Loic74650/PoolMaster/docs/Blynk.jpg

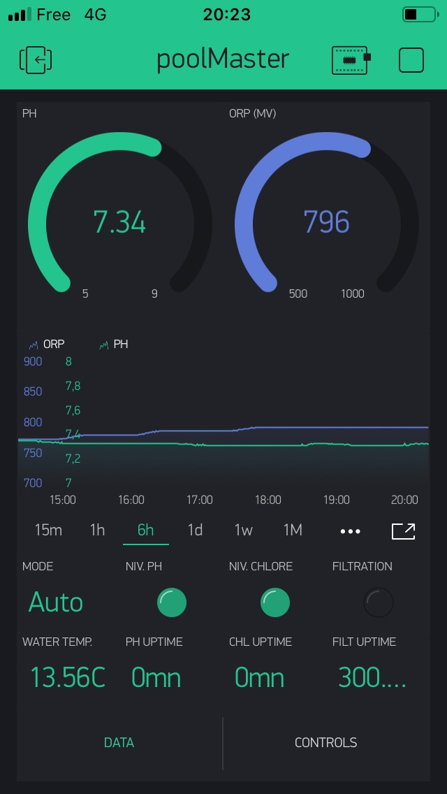
docs/Blynk.jpg
