Loic74650/PoolMaster/docs/Grafana2.png

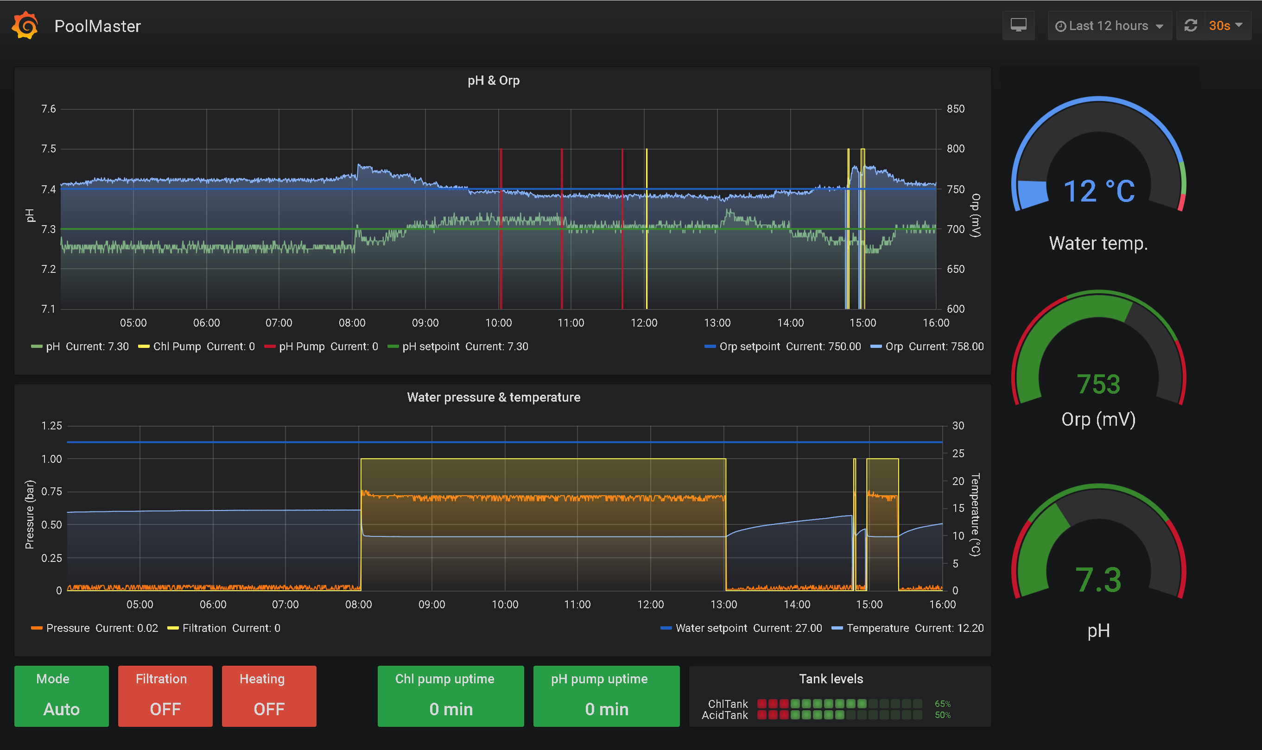
docs/Grafana2.png
