Loic74650/PoolMaster/docs/MeasuringChamberPickup.JPG

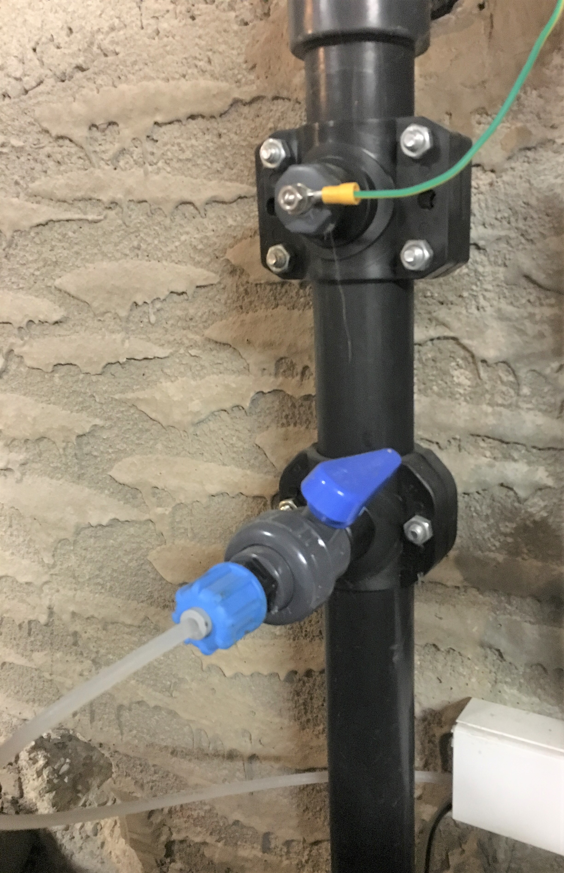
docs/MeasuringChamberPickup.JPG
