Loic74650/PoolMaster/docs/OneWayInjectionNozzles.JPG

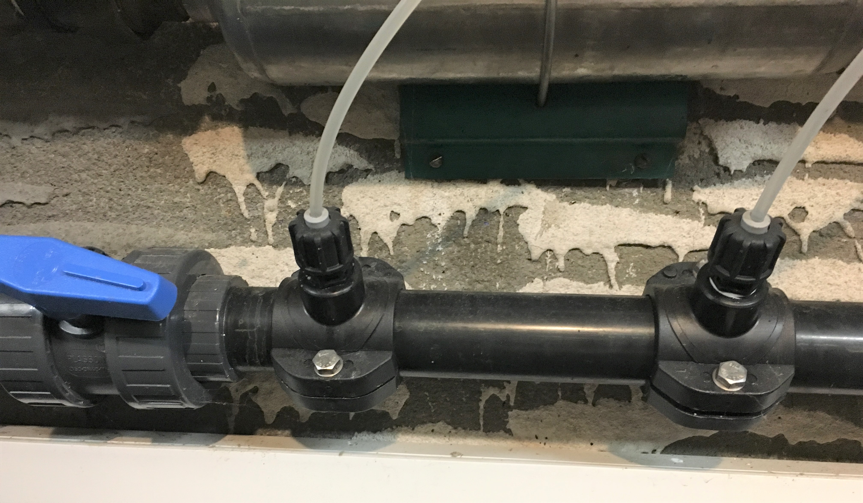
docs/OneWayInjectionNozzles.JPG
