Loic74650/PoolMaster/docs/Plumbing.png

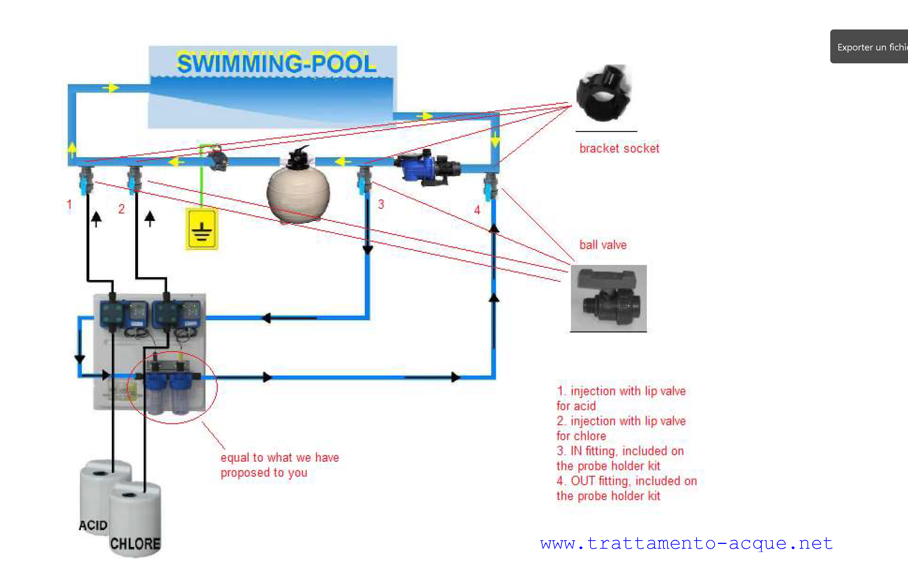
docs/Plumbing.png
