Loic74650/PoolMaster/docs/PoolMaster.jpg

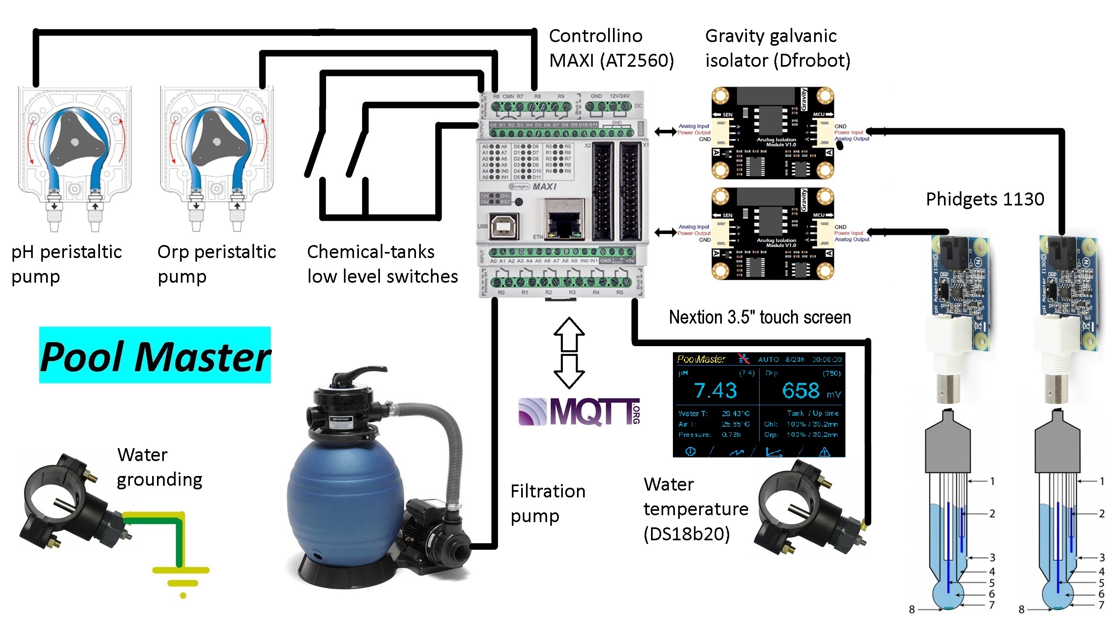
docs/PoolMaster.jpg
