Loic74650/PoolMaster/docs/PoolMaster_2.jpg

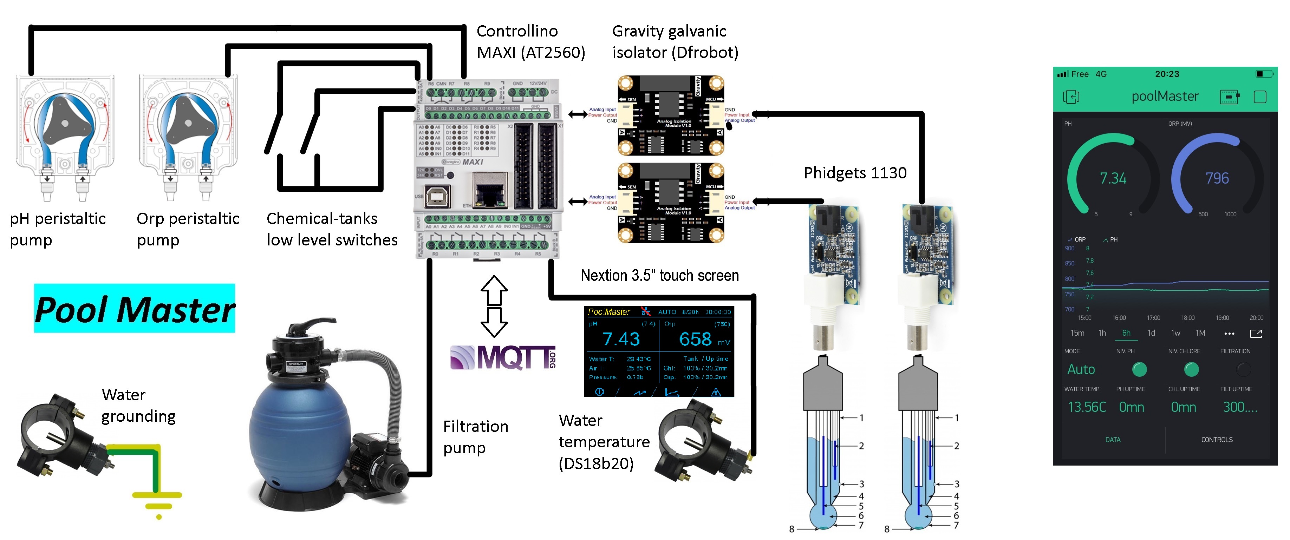
docs/PoolMaster_2.jpg
