Loic74650/PoolMaster/docs/TemperatureProbe.JPG

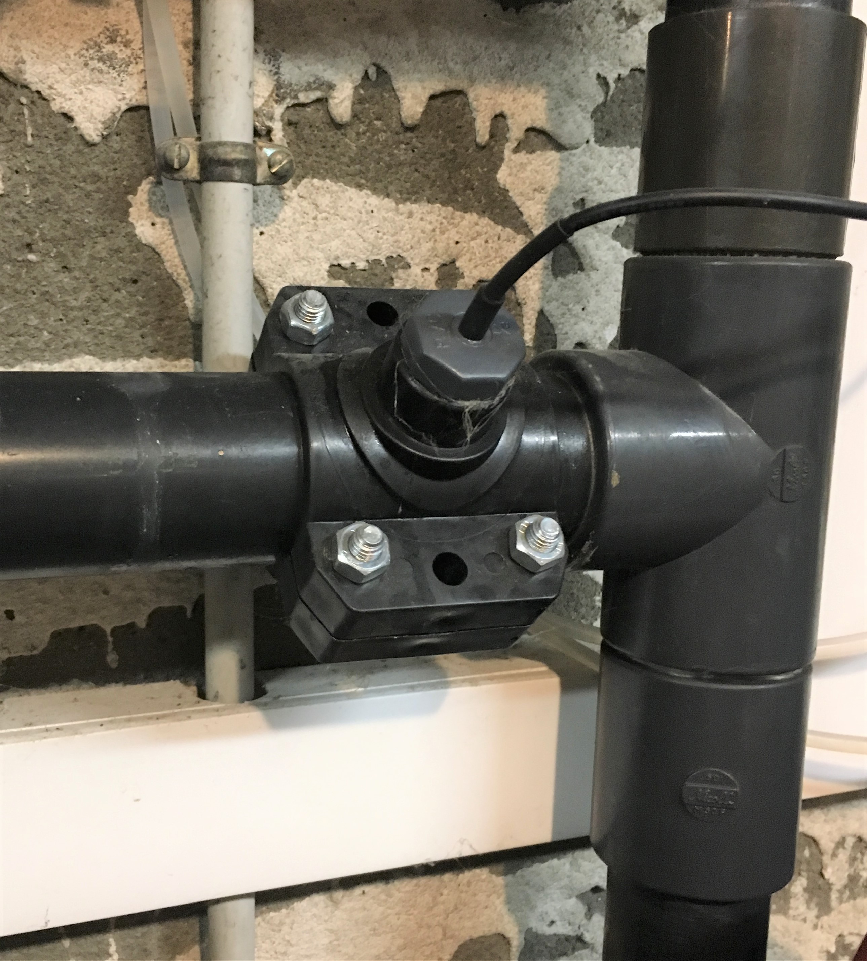
docs/TemperatureProbe.JPG
