Loic74650/PoolMaster/docs/Probes cross-talk test.jpg

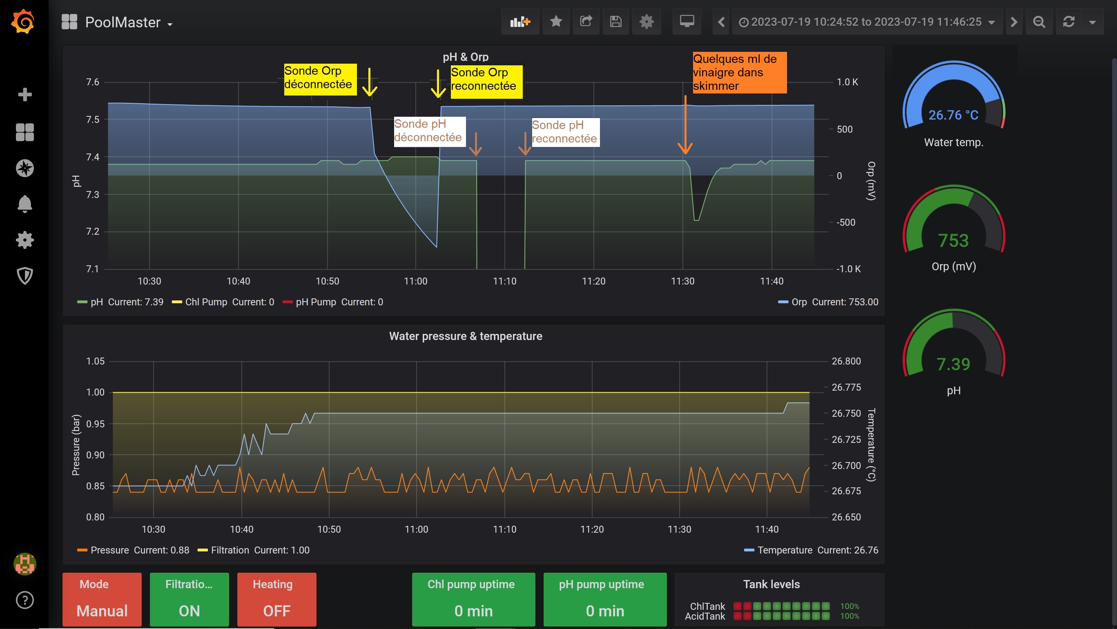
docs/Probes cross-talk test.jpg
