Loic74650/PoolMaster/(threads)

Thread 1 (2020-01-17):

Ajout Wifi NodeMCU V3 Esp8266

Cheveux, 2020-01-17:
très bon projet que je souhaite mettre en place chez moi mais étant tout nouveau dans ce domaine, j'essaye depuis quelques jours de remplacer la Shield ethernet par une nodeMcu V3 a base d'ESP8266 (ESP-12E).
Si tu as une idée sur comment flasher l'ESP pour pouvoir l'utiliser comme un Shield.

Loic74650, 2020-01-17:
Hello Cheveux

Désolé je n’ai pas d’expérience avec ESP

Loic

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

Cheveux, 2020-01-18:
ok merci pour l'info penses tu que si je prend un Arduino wifi R3 atmega2560 (a base de esp8266) je pourrais facilement adapter le projet ? j'ai besoin de passer par wifi car je ne souhaite pas passer par CPL dans mon local

Loic74650, 2020-01-18:
A partir du moment où tu restes sur des micro compatibles avec l’IDE Arduino, ça devrait aller. Par contre commence par passer en revue les librairies du projet PoolMaster et vérifie qu’elles prennent en charge le micro vers lequel tu veux migrer

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

Closed 2020-02-05.

Thread 5 (2020-05-25):

{"PSIHigh":1.0}  upper or lower limit?

bbwouters, 2020-05-25:
{"PSIHigh":1.0}                  -> set the water high-pressure threshold (1.0bar in this example). When water pressure is over that threshold, an error flag is set.

Could it be the PSIHigh sets the lower limit for the filtration pump to run in stead of the upper limit?

 //If filtration pump has been running for over 7secs but pressure is still low, stop the filtration pump, something is wrong, set error flag
    if(FiltrationPump.IsRunning() && ((millis() - FiltrationPump.LastStartTime)>7000) && (storage.PSIValue < storage.PSI_MedThreshold))
    {
      FiltrationPump.Stop();

Setting it at 1 bar in my cofig happily runs the pump generating a constant  5 bar.

I think the check is correct "if you see no pressure buildup there is a problem and stop the pomp" but the description is incorrect.

Loic74650, 2020-05-25:
I think all is correct, BUT:

*	storage.PSI_MedThreshold Is the variable used to detect a low pressure (0.25b by default in EEPROM, and no API function to change it)
*	storage.PSI_HighThreshold Is the variable to detect a high pressure (sand filter needs cleaning) but the error detection / flag is not implemented

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

bbwouters, 2020-05-25:
OK that explains why I do not get an error at 5 bar with 1.0 bar threshold.

Sorry for creating confusion.

Van: "Loic74650" <notifications@github.com>
Aan: "Loic74650/PoolMaster" <PoolMaster@noreply.github.com>
Cc: "bwouters" <bwouters@telenet.be>, "Author" <author@noreply.github.com>
Verzonden: Maandag 25 mei 2020 23:39:47
Onderwerp: Re: [Loic74650/PoolMaster] {"PSIHigh":1.0} upper or lower limit? (#5)

I think all is correct, BUT:

* storage.PSI_MedThreshold Is the variable used to detect a low pressure (0.25b by default in EEPROM, and no API function to change it)
* storage.PSI_HighThreshold Is the variable to detect a high pressure (sand filter needs cleaning) but the error detection / flag is not implemented

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

Closed 2020-05-27.

Thread 19 (2020-05-31):

{"DelayPID":60}  when re-start during filter pump window

bbwouters, 2020-05-31:
Are we sure if the system is re-booted during the Flirtation pump window/ hours the PID regulation is delayed and does not start immediately regulating based on water left in the tubes (and therefore not reflecting real water quality?  Same question is valid when pump is manually stopped and started  during filtration hours. (As a matter of safety).

So does PHRegulationCallback(Task* me) checks when Firltration pump was last started? I don't think so but your insight would be appreciated.

Loic74650, 2020-05-31:
Correct it does not.

I'd like the PHRegulationCallback(Task* me) to remain as clean and simple as possible, so I suggest that any future checks should be either performed in the generic loop or in the lower level Pump class.

In this particular case the simplest way to do this I think, is to reset the FiltrationPump.UpTime property after a manual stop/restart of the filtration. That way it will wait for another DelayPID before it regulates again. The downside is that it will messup the filtration real duration statistic for that particular day (maybe not so critical).

A slightly more correct/complex way of doing things would be to increase the value of storage.DelayPIDs variable by the FiltrationPump.UpTime value after each start/stop of the filtration:

storage.DelayPIDs += FiltrationPump.UpTime

That way when it restarts, it has to wait for another while before starting the regulation again.
At midnight, storage.DelayPIDs should be reset to its default value.

We also have to discuss whether EmergencyStopFiltPump should be reset at midnight or not (ie. should the double-tap feature be used for long-term filtration management or just small daily tasks)

bbwouters, 2020-05-31:
In my opinion: EmergencyStopFiltPump should be reset at midnight , "emergency" should the double-tap feature be used for small daily tasks, but a warning in the documentation it will restart next day.

Van: "Loic74650" <notifications@github.com>
Aan: "Loic74650/PoolMaster" <PoolMaster@noreply.github.com>
Cc: "bwouters" <bwouters@telenet.be>, "Author" <author@noreply.github.com>
Verzonden: Zondag 31 mei 2020 15:13:15
Onderwerp: Re: [Loic74650/PoolMaster] {"DelayPID":60} when re-start during filter pump window (#19)

Correct it does not.

I'd like the PHRegulationCallback(Task* me) to remain as clean and simple as possible, so I suggest that any future checks should be either performed in the generic loop or in the lower level Pump class.

In this particular case the simplest way to do this I think, is to reset the FiltrationPump.UpTime property after a manual stop/restart of the filtration. That way it will wait for another DelayPID before it regulates again. The downside is that it will messup the filtration real duration statistic for that particular day (maybe not so critical).

A slightly more correct/complex way of doing things would be to increase the value of storage.DelayPIDs variable by the FiltrationPump.UpTime value after each start/stop of the filtration:

storage.DelayPIDs += FiltrationPump.UpTime

That way when it restarts, it has to wait for another while before starting the regulation again.
At midnight, storage.DelayPIDs should be reset to its default value.

We also have to discuss whether EmergencyStopFiltPump should be reset at midnight or not (ie. should the double-tap feature be used for long-term filtration management or just small daily tasks)

—
You are receiving this because you authored the thread.
Reply to this email directly, [ https://github.com/Loic74650/PoolMaster/issues/19#issuecomment-636469779 | view it on GitHub ] , or [ https://github.com/notifications/unsubscribe-auth/AO7R6ZSMCNQJKHAPQR32LZ3RUJJWXANCNFSM4NPEVYHA | unsubscribe ] .

Loic74650, 2020-05-31:
`In my opinion: EmergencyStopFiltPump should be reset at midnight , "emergency" should the double-tap feature be used for small daily tasks, but a warning in the documentation it will restart next day.`

I agree and will make the change

bbwouters, 2020-05-31:
unsigned long LastStartTime;

can also be used to make a check with to take into account PID delay

I'll have a look

Van: "Loic74650" <notifications@github.com>
Aan: "Loic74650" <PoolMaster@noreply.github.com>
Cc: "bwouters" <bwouters@telenet.be>, "Author" <author@noreply.github.com>
Verzonden: Zondag 31 mei 2020 15:13:15
Onderwerp: Re: [Loic74650/PoolMaster] {"DelayPID":60} when re-start during filter pump window (#19)

Correct it does not.

I'd like the PHRegulationCallback(Task* me) to remain as clean and simple as possible, so I suggest that any future checks should be either performed in the generic loop or in the lower level Pump class.

In this particular case the simplest way to do this I think, is to reset the FiltrationPump.UpTime property after a manual stop/restart of the filtration. That way it will wait for another DelayPID before it regulates again. The downside is that it will messup the filtration real duration statistic for that particular day (maybe not so critical).

A slightly more correct/complex way of doing things would be to increase the value of storage.DelayPIDs variable by the FiltrationPump.UpTime value after each start/stop of the filtration:

storage.DelayPIDs += FiltrationPump.UpTime

That way when it restarts, it has to wait for another while before starting the regulation again.
At midnight, storage.DelayPIDs should be reset to its default value.

We also have to discuss whether EmergencyStopFiltPump should be reset at midnight or not (ie. should the double-tap feature be used for long-term filtration management or just small daily tasks)

—
You are receiving this because you authored the thread.
Reply to this email directly, [ https://github.com/Loic74650/PoolMaster/issues/19#issuecomment-636469779 | view it on GitHub ] , or [ https://github.com/notifications/unsubscribe-auth/AO7R6ZSMCNQJKHAPQR32LZ3RUJJWXANCNFSM4NPEVYHA | unsubscribe ] .

Loic74650, 2020-06-01:
`unsigned long LastStartTime; can also be used to make a check with to take into account PID delay`

Correct. LastStartTime could be used to check how long the filtration was stopped for. If longer than, say, 1 hour, a delay should be applied before restarting the PIDs

Loic74650, 2020-06-02:
I gave some thoughts to this issue and how to handle it.
It becomes unecessarily complicated once you wish to handle several double-taps in a row.

Therefore v5.0.0 is now using a simple check before it starts the PIDS, I have replaced the following condition:

(FiltrationPump.UpTime/1000/60 > storage.DelayPIDs)

with:

(FiltrationPump.LastStartTime / 1000 / 60 > storage.DelayPIDs)

It has the inconvenience to enforce a DelayPID every time you stop/restart the filtration but in practice that should not be abig issue and that keeps things simple

bbwouters, 2020-06-02:
Perfect solution!

Van: "Loic74650" <notifications@github.com>
Aan: "Loic74650" <PoolMaster@noreply.github.com>
Cc: "bwouters" <bwouters@telenet.be>, "Author" <author@noreply.github.com>
Verzonden: Dinsdag 2 juni 2020 12:49:27
Onderwerp: Re: [Loic74650/PoolMaster] {"DelayPID":60} when re-start during filter pump window (#19)

I gave some thoughts to this issue and how to handle it.
It becomes unecessarily complicated once you wish to handle several double-taps in a row.

Therefore v5.0.0 is now using a simple check before it starts the PIDS, I have replaced the following condition:

(FiltrationPump.UpTime/1000/60 > storage.DelayPIDs)

with:

(FiltrationPump.LastStartTime / 1000 / 60 > storage.DelayPIDs)

It has the inconvenience to enforce a DelayPID every time you stop/restart the filtration but in practice that should not be abig issue and that keeps things simple

—
You are receiving this because you authored the thread.
Reply to this email directly, [ https://github.com/Loic74650/PoolMaster/issues/19#issuecomment-637456122 | view it on GitHub ] , or [ https://github.com/notifications/unsubscribe-auth/AO7R6ZRF5VA7ILOVXNSUVYDRUTKLPANCNFSM4NPEVYHA | unsubscribe ] .

Loic74650, 2020-06-16:
Hi Boris

Found the bug with DelayPID behaviour and the use of LastStartTime

I fixed it

Cheers

Loic

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

bbwouters, 2020-06-16:
Perfect!

Van: "Loic74650" <notifications@github.com>
Aan: "Loic74650" <PoolMaster@noreply.github.com>
Cc: "bwouters" <bwouters@telenet.be>, "Author" <author@noreply.github.com>
Verzonden: Dinsdag 16 juni 2020 11:17:48
Onderwerp: Re: [Loic74650/PoolMaster] {"DelayPID":60} when re-start during filter pump window (#19)

Hi Boris

Found the bug with DelayPID behaviour and the use of LastStartTime

I fixed it

Cheers

Loic

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

Closed 2020-06-02.

Thread 24 (2020-06-18):

Wrong dimension s/h

bbwouters, 2020-06-18:
{"pHPumpFR":1.5}                 -> call this command to set pH pump flow rate un L/s. In this example 1.5L/s
  {"ChlPumpFR":3}                  -> call this command to set Chl pump flow rate un L/s. In this example 3L/s

needs to be L/h no?

Loic74650, 2020-06-18:
Ah yes, thx, corrected it

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

Closed 2020-06-18.

Thread 25 (2020-06-18):

Relay comments to be adjusted

bbwouters, 2020-06-18:
R1: state of Relay1
    R2: state of Relay1
    R6: state of Relay1
    R7: state of Relay1

   R1: state of Relay1
    R2: state of Relay2
    R6: state of Relay6
    R7: state of Relay7

Loic74650, 2020-06-18:
Corrected, thank you

Closed 2020-06-18.

Thread 26 (2020-06-27):

arduino-queue does not free memory

Faexa, 2020-06-27:
Hi,
I'm building my own script step by step, learning arduino by the way and C programming, using (all) parts of yours.
I noticed that the arduino queue you're using (https://github.com/sdesalas/Arduino-Queue.h) does not free memory when queue is emptying.
If I spam the queue to the max with MQTT commands, it will eat memory up to (max number of items queued) * (MQTTClient packet size, which is 128bits by default) (so with your settings 1k), and will never release these allocation when emptying.
I tried this arduino-queue (https://github.com/EinarArnason/ArduinoQueue) which behave differently and release the allocations. I get the same free RAM when the queue is empty that I had before spaming the queue.

It's a corner case, I doubt we would spam ourselves with MQTT commands...

Thanks for you good job with this script ! Really like it :)

Loic74650, 2020-06-27:
Thank you Faexa,

This is not really a bug but rather a poor RAM management from the current queue library in conjunction with my code using the String class which also does a poor job at managing RAM...  The String objects holding the command payloads are allocated and never released by the queue class, as you noted. Then the String objects can only grow in size with longer commands coming in, and never decrease in size even with smaller commands coming in, leading to what you saw.

So in the development branch of the project (version 5.0.0 coming up) I have replaced the current queue library with the one you found, which does a much better job, thank you!

Closed 2020-07-01.

Thread 27 (2020-12-30):

Nextion variable update missing

Gixy31, 2020-12-30:
When updating Filtration Start/Stop hours, the page0.vaStaSto.txt should be set with the new string in order to force updating of the field on all pages.
add this line after line #154:
myNex.writeStr(F("page0.vaStaSto.txt"), temp);

Loic74650, 2020-12-30:
Thanks Gixy31, I believe I fixed that issue in my December 1st update of the develop branch, kindly confirm

Gixy31, 2020-12-30:
You're right! I was using the master branch.
Another fix in your pump library: on many relay boards, the relays are activated when pulling the input LOW ; to cope with that, you must not only invert the PUMP_ON, PUMP_OFF, INTERLOCK_OK and INTERLOCK_NOK constants, but you must also change the _isrunning_  and _Interlock_ functions like this:
return (digitalRead(isrunningsensorpin) == PUMP_ON);
return (digitalRead(interlockpin) == PUMP_ON);
And for the addtionnal relays commands, the digitalWrite instructions should also be inverted in the ProcessCommand() function.
All the best,
Denis

Loic74650, 2021-01-01:
Pump library: yes, nice catch
I think however that:

return (digitalRead(interlockpin) == PUMP_ON);

should be:

return (digitalRead(interlockpin) == INTERLOCK_OK);

Gixy31, 2021-01-01:
Exact, copiė collé malheureuxLe 1 janv. 2021 20:36, Loic74650 <notifications@github.com> a écrit :
Pump library: yes, nice catch
I think however that:
return (digitalRead(interlockpin) == PUMP_ON);
should be:
return (digitalRead(interlockpin) == INTERLOCK_OK);

—You are receiving this because you authored the thread.Reply to this email directly, view it on GitHub, or unsubscribe.

Closed 2021-01-01.

Thread 28 (2021-03-18):

Compiling error

jdienlin, 2021-03-18:
Hi!
Really fascinated by your project! I have installed all libraries, using a Controllino Maxi board, however I receive the following error while compiling:

"Archiving built core (caching) in: C:\Users\jdienlin\AppData\Local\Temp\arduino_cache_542260\core\core_CONTROLLINO_Boards_avr_controllino_maxi_0c812875ac70eb4a9b385d8fb077f54c.a
C:\Users\jdienlin\Documents\Arduino\PoolMaster-master\PoolMaster-master\source\PoolMaster\PoolMaster.ino: In function 'simpLinReg':

PoolMaster:1876: error: unable to find a register to spill in class 'POINTER_REGS'

 }

 ^

PoolMaster:1876: error: this is the insn:

(insn 52 51 54 3 (set (reg:SF 67 [ D.2628 ])

        (mem:SF (post_inc:HI (reg:HI 82 [ ivtmp.77 ])) [12 MEM[base: _52, offset: 0B]+0 S4 A8])) C:\Users\jdienlin\Documents\Arduino\PoolMaster-master\PoolMaster-master\source\PoolMaster\PoolMaster.ino:1863 100 {*movsf}

     (expr_list:REG_INC (reg:HI 82 [ ivtmp.77 ])

        (nil)))

"

Any ideas?

Thanks!
Jonathan

Loic74650, 2021-03-18:
Hi
It's a bug from the compiler, you have to update the IDE and the arduino.avr-gcc

jdienlin, 2021-03-18:
Hi, thanks for the quick reply. Updating the compiler fixed the issue - big THANK YOU!

Closed 2021-03-18.

Thread 29 (2021-06-21):

information

maury77, 2021-06-21:
I would need a simplified version for water monitoring.

It is possible to use it on

Arduino UNO R3 ATmega328P + WiFi ESP8266

arnolde, 2021-06-21:
I would think even an ESP8266 alone should do the trick... I'd be interested too, in case anybody gets into that.
I recently bought a PH-803W pool controller for 80€ on Aliexpress, it containes an ESP8266 too, but also a square microcontroller (type filed off). It's not bad, the app sucks, but I wrote a perl script to catch the UDP broadcasts of the ph+orp values and post them to an influxdb+grafana instance on my webserver. Other stuff includes Maxim ICL 7612D (for pH) and 7612A (for ORP) opamps and 2xTEL 6N137 optocouplers.

Loic74650, 2021-06-21:
PoolMAster was ported to ESP32 by @Gixy31, see here: https://github.com/Gixy31/ESP32-PoolMaster

Closed 2021-07-11.

Thread 35 (2023-07-02):

Pump action is inverted

henjo, 2023-07-02:
Hi,
Thanks for a great project.
I am trying to build a chlorine controller with a Controllino Maxi with the Poolmaster SW.
At start the ORP and chlorine pump relays are all turned on and I have tracked down the problem to the definition of PUMP_ON macro in Pump.h. It is defined as active low which seems to be opposite to the way my Controllino hardware works. If the relay action is hardware dependent maybe it is good to have it as a parameter to the Pump class.

Loic74650, 2023-07-03:
Hi
Good point, will add it to the todo list!

Loic74650, 2023-07-04:
On a second thought, this issue could also come up with the other defines such as TANK_FULL/TANK_EMPTY and INTERLOCK_OK/INTERLOCK_NOK, but it would not be super elegant to have them all as parameters in the class constructor, would it? Any suggestion for a better way to do this?

henjo, 2023-07-05:
How about adding only one of the constants (PUMP_ON, TANK_FULL,
INTERLOCK_OK) as parameters to the constructor since they are binary
constants. So then there are 3 additional parameters to the constructor.
Not super elegant either.

/Henrik

2023-07-04 22:40 skrev Loic74650:

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

Links:
------
[1]
https://github.com/Loic74650/PoolMaster/issues/35#issuecomment-1620724351
[2]
https://github.com/notifications/unsubscribe-auth/AAAIXZ5ZDRXLDZM7WO55LXLXOR5UXANCNFSM6AAAAAAZ3OI3Z4

Thread 44 (2025-05-16):

PH Temperature compensation

masterpj555, 2025-05-16:
Hi there Loic! Sorry for messaging you here as my knowledge of github is low.

Amazing project! I started attemtping to build my own using poolmaster.

I found some really good industrial PH sensors far cheaper then atlas scientific with temperature compensation
(140 with a controller, 89 without a controller compared to 319 from atlas scientific).

Now my question: Is it possible to add PH temperature compensation to poolmaster? It would increase accuracy.
I was under the impression the PH/ORP sensor board only does amplification and DAC.

Loic74650, 2025-05-16:
+/-0.1 is probably maintained within that range without temp compensation. Whats more, reference solutions used to calibrate pH indicate the pH value to be used over that temperature range, so in a way it is already compensated for without actively doing it in the code, assuming the temperature stays relatively constant between calibrations. In the last resort, the function GetMeas() in the code shows how to use temp. compensation if really desired (it may need to be updated to work with the pH_Orp board)

masterpj555, 2025-05-16:
0.1 is plenty sufficient! I'm mostly wondering because i've seen some really eratic charts of scientific publications.. i have to check how far the drift is.. but in my country it (and so in france i believe) it can get quite cold and hot sporadically in the summer.

For example 15 degrees to sudden 28 degrees another day . I want to add wood fired and solar heated pool heating to my pool which means temps do tend to spike every now and then and not be consistent. if it despite that stays within 0.1 degrees then no problem but somehow I doubt it will.

masterpj555, 2025-05-16:
> pool

it may be wise to have redundancy anyway! in case of the sending a low cost temperature sensor can be added as a sort of low effort comparitor just for the pure sake of failure of a temperature sensor.. it wont be perfect but that redundancy can be used for error reporting. I do understand 2 probes is costly since it's a consumable.

arnolde, 2025-05-16:
> For example 15 degrees to sudden 28 degrees another day

Your pool water won't change temerature that fast. I have 20m³ and the temperature only sinks 1° or max 2° overnight.
During Covid I heated it to 32° in winter and it went down 4° overnight (freezing temps outside, covered the surface in 4cm styrofoam when not using) (not recommended btw, they soaked up the water)

masterpj555, 2025-05-16:
> > For example 15 degrees to sudden 28 degrees another day
>
> Your pool water won't change temerature that fast. I have 20m³ (completely underground) and the temperature only sinks 1° or max 2° overnight. During Covid I heated it to 32° in winter and it went down 4° overnight (freezing temps outside, covered the surface in 4cm styrofoam when not using) (not recommended btw, they soaked up the water)

fair but since you want this system to sort of reduce your work on the pool the more hands off it is the better... say you could leave it more unattended over a period of 2~3 weeks youll have a fair bit of drift which will affect dosing.. possibly more chemicals are wasted in the process of adjusting back and forth.

Closed 2025-05-16.
