Loic74650/PoolMaster/source/PoolMaster.ino/PoolMaster.ino.ino

/*
Arduino/Controllino-Maxi (ATmega2560) based Ph/ORP regulator for home pool sysem. No warranty, use at your own risk
(c) Loic74 <loic74650@gmail.com> 2018

***Compatibility***
For this sketch to work on your setup you must change the following in the code:
- possibly the pinout definitions in case you are not using a CONTROLLINO MAXI board
- the code related to the RTC module in case your setup does not have one
- MAC address of DS18b20 water temperature sensor
- MAC and IP address of the Ethernet shield
- MQTT broker IP address and login credentials
- possibly the topic names on the MQTT broker to subscribe and publish to
- the Kp,Ki,Kd parameters for both PID loops in case your peristaltic pumps have a different throughput than 2Liters/hour. For instance, if twice more, divide the parameters by 2

***Brief description:***
Three main metrics are measured and periodically reported over MQTT: water temperature, PH and ORP values
Pumps states, tank-level states and other parmaters are also periodically reported
Two PID regulation loops are running in parallel: one for PH, one for ORP
PH is regulated by injecting Acid from a tank into the pool water (a relay starts/stops the Acid peristaltic pump)
ORP is regulated by injecting Chlorine from a tank into the pool water (a relay starts/stops the Chlorine peristaltic pump)
Defined time-slots and water temperature are used to start/stop the filtration pump for a daily given amount of time (a relay starts/stops the filtration pump) 
A lightweight webserver provides a simple dynamic webpage with a summary of all system parameters
Communication with the system is performed using the MQTT protocol over an Ethernet connection to the local network/MQTT broker.

Every 30 seconds (by default), the system will publish on the "PoolTopic" (see in code below) the following payloads in Json format:

Temp: measured Water temperature value in °C
Ph: measured Ph value
PhError/100: Ph PID regulation loop instantaneous error
Orp: measured Orp (Redox) value
OrpError/100: Orp PID regulation loop instantaneous error 
FiltUpTime: current running time of Filtration pump in seconds (reset every 24h)
PhUpTime: current running time of Ph pump in seconds (reset every 24h)
ChlUpTime: current running time of Chl pump in seconds (reset every 24h)
IO & IO2: two variables of type BYTE where each individual bit is the state of a digital input on the Arduino. These are:

IO:
FiltPump: current state of Filtration Pump (1=on, 0=off)
PhPump: current state of Ph Pump (1=on, 0=off)
ChlPump: current state of Chl Pump (1=on, 0=off)
PhlLevel: current state of Acid tank level (0=empty, 1=ok)
ChlLevel: current state of Chl tank level (0=empty, 1=ok)
Mode: (0=manual, 1=auto). 
pHErr: pH pump overtime error flag
ChlErr: Chl pump overtime error flag

IO2:
pHPID: current state of pH PID regulation loop (1=on, 0=off)
OrpPID: current state of Orp PID regulation loop (1=on, 0=off)
   
***MQTT API***
Below are the Payloads/commands to publish on the "PoolTopicAPI" topic (see in code below) in Json format in order to launch actions on the Arduino:
{"Mode":1} or {"Mode":0}         -> set "Mode" to manual (0) or Auto (1). In Auto, filtration starts/stops at set times of the day 
{"FiltPump":1} or {"FiltPump":0} -> manually start/stop the filtration pump. 
{"ChlPump":1} or {"ChlPump":0}   -> manually start/stop the Chl pump to add more Chlorine
{"PhPump":1} or {"PhPump":0}     -> manually start/stop the Acid pump to lower the Ph
{"PhPID":1} or {"PhPID":0}       -> start/stop the Ph PID regulation loop
{"OrpPID":1} or {"OrpPID":0}     -> start/stop the Orp PID regulation loop
{"PhCalib":[4.02,3.8,9.0,9.11]}  -> multi-point linear regression calibration (minimum 1 point-couple, 6 max.) in the form [ProbeReading_0, BufferRating_0, xx, xx, ProbeReading_n, BufferRating_n]
{"OrpCalib":[450,465,750,784]}   -> multi-point linear regression calibration (minimum 1 point-couple, 6 max.) in the form [ProbeReading_0, BufferRating_0, xx, xx, ProbeReading_n, BufferRating_n]
{"PhSetPoint":7.4}               -> set the Ph setpoint, 7.4 in this example
{"OrpSetPoint":750.0}            -> set the Orp setpoint, 750mV in this example
{"WSetPoint":27.0}               -> set the water temperature setpoint, 27.0deg in this example (for future use. Water heating not handled yet)
{"WTempLow":10.0}                -> set the water low-temperature threshold below which there is no need to regulate Orp and Ph (ie. in winter)
{"OrpPIDParams":[2857,0,0]}      -> respectively set Kp,Ki,Kd parameters of the Orp PID loop. In this example they are set to 2857, 0 and 0
{"PhPIDParams":[1330000,0,0.0]}  -> respectively set Kp,Ki,Kd parameters of the Ph PID loop. In this example they are set to 1330000, 0 and 0.0
{"OrpPIDWSize":1800000}           -> set the window size of the Orp PID loop in msec, 30mins in this example
{"PhPIDWSize":1800000}            -> set the window size of the Ph PID loop in msec, 30mins in this example
{"Date":[1,1,1,18,13,32,0]}      -> set date/time of RTC module in the following format: (Day of the month, Day of the week, Month, Year, Hour, Minute, Seconds), in this example: Monday 1st January 2018 - 13h32mn00secs
{"FiltT0":9}                     -> set the earliest hour (9:00 in this example) to run filtration pump. Filtration pump will not run beofre that hour
{"FiltT1":20}                    -> set the latest hour (20:00 in this example) to run filtration pump. Filtration pump will not run after that hour
{"PubPeriod":30}                 -> set the periodicity (in seconds) at which the system info (pumps states, tank levels states, measured values, etc) will be published to the MQTT broker
{"PumpsMaxUp":1800}              -> set the Max Uptime (in secs) for the Ph and Chl pumps over a 24h period. If over, PID regulation is stopped and a warning flag is raised
{"Clear":1}                      -> reset the pH and Orp pumps overtime error flags in order to let the regulation loops continue. "Mode", "PhPID" and "OrpPID" commands need to be switched back On (1) after an error flag was raised

***Libraries***
https://github.com/256dpi/arduino-mqtt/releases
https://github.com/CONTROLLINO-PLC/CONTROLLINO_Library
https://github.com/PaulStoffregen/OneWire
https://github.com/milesburton/Arduino-Temperature-Control-Library
https://github.com/RobTillaart/Arduino/tree/master/libraries/RunningMedian
https://github.com/prampec/arduino-softtimer
https://github.com/bricofoy/yasm
https://github.com/br3ttb/Arduino-PID-Library
https://github.com/bblanchon/ArduinoJson
https://github.com/arduino-libraries/LiquidCrystal

*/ 
#include <SPI.h>
#include <Ethernet.h>
#include <MQTT.h>
#include <SD.h>
#include "OneWire.h"
#include <DallasTemperature.h>
#include <Controllino.h>
#include <EEPROM.h>
#include <RunningMedian.h>
#include <SoftTimer.h>
#include <yasm.h>
#include <PID_v1.h>
#include <Streaming.h>
#include <LiquidCrystal.h>
#include <avr/wdt.h>
#include <stdlib.h>
#include <ArduinoJson.h>

// Firmware revision
String Firmw = "2.0.0";

//LCD init.
//LCD connected on pin header 2 connector, not on screw terminal (/!\)
//pin definitions, may vary in your setup
const int rs = 9, en = 10, d4 = 11, d5 = 12, d6 = 13, d7 = 42;
LiquidCrystal lcd(rs, en, d4, d5, d6, d7);

//buffer used to capture HTTP requests
String readString;

//buffers for MQTT string payload
#define PayloadBufferLength 128
char Payload[PayloadBufferLength];

//output relays pin definitions
#define FILTRATION_PUMP CONTROLLINO_R4  //CONTROLLINO_RELAY_4
#define PH_PUMP    CONTROLLINO_R1       //CONTROLLINO_RELAY_1
#define CHL_PUMP   CONTROLLINO_R5       //CONTROLLINO_RELAY_5

//Digital input pins connected to Acid and Chl tank level reed switches
#define CHL_LEVEL  CONTROLLINO_D1       //CONTROLLINO_D1 pin 3
#define PH_LEVEL   CONTROLLINO_D3       //CONTROLLINO_D3 pin 5

//Analog input pins connected to Phidgets 1130_0 pH/ORP Adapters. 
//Galvanic isolation circuitry between Adapters and Arduino required!
#define ORP_MEASURE CONTROLLINO_A2      //CONTROLLINO_A2 pin A2 on pin header connector, not on screw terminal (/!\)
#define PH_MEASURE  CONTROLLINO_A4      //CONTROLLINO_A4 pin A4 on pin header connector, not on screw terminal (/!\)


//***EEPROM-stored variables and their default values***

//Temporary variables used to store various data types into the EEPROM
String temp_str;
bool BVar;
float fVar;
byte bVar;
unsigned int uiVar;
unsigned long ulVar;

//Enabled/disabled status of the PID regulations
byte Ph_RegulationOnOff = 1;      //ON = 1; OFF = 0;
byte Orp_RegulationOnOff = 1;     //ON = 1; OFF = 0;

//Filtration start and stop hours
unsigned int FiltrationStart = 8;
unsigned int FiltrationDuration = 12;
unsigned int FiltrationStopMax = 20;
unsigned int FiltrationStop;

//TimeCounters, keep track of how long a pump has been running for over the last 24hours period
//(in millisecs)
unsigned long FiltrationPumpTimeCounter = 0;
unsigned long PhPumpTimeCounter = 0;
unsigned long ChlPumpTimeCounter = 0;
unsigned long FiltrationPumpTimeCounterStart = 0;
unsigned long PhPumpTimeCounterStart = 0;
unsigned long ChlPumpTimeCounterStart = 0;

//PH and ORP Setpoints
double Ph_SetPoint = 7.4f;
double Orp_SetPoint = 750.0f;

//PH and ORP calibration coefficients (slope and offset)
float pHCalibCoeffs[] = {3.56f, -1.889f};
float OrpCalibCoeffs[] = {-964.32f, 2410.8f};

//Water temperature low threshold. Stop regulations below this temp (ie. in winter) 
float WaterTempLowThreshold = 10.0f;

//Water temperature setpoint. Currently not in use
float WaterTemp_SetPoint = 27.0f;

//Ph PID constants
double Ph_Kp = 1330000;
double Ph_Ki = 0;
double Ph_Kd = 0;

//Orp PID constants
double Orp_Kp = 2857;
double Orp_Ki = 0;
double Orp_Kd = 0;

//PID output errors
double PhPIDOutput, OrpPIDOutput;

//PID window sizes
unsigned long PhPIDWindowSize =  1800000;//30 mins
unsigned long OrpPIDWindowSize = 1800000;//30 mins
unsigned long PhPIDwindowStartTime;
unsigned long OrpPIDwindowStartTime;

//Pumps max uptime limit (in secs) per 24h
unsigned int PhPumpUpTimeLimit = 1800;//30 mins
unsigned int ChlPumpUpTimeLimit = 1800;//30 mins
bool PhUpTimeError = 0;
bool ChlUpTimeError = 0;

//Measurement results (Temperature, Ph, ORP)
double TempValue = -1.0;
double PhValue = -1.0;
double OrpValue = -1.0;

//PIDs instances
//Specify the links and initial tuning parameters
PID PhPID(&PhValue, &PhPIDOutput, &Ph_SetPoint, Ph_Kp, Ph_Ki, Ph_Kd, REVERSE);
PID OrpPID(&OrpValue, &OrpPIDOutput, &Orp_SetPoint, Orp_Kp, Orp_Ki, Orp_Kd, DIRECT);

//Filtration/regulation mode: auto (1) or manual (0)
bool AutoMode = 0;

//BitMaps with GPIO states
unsigned char BitMap = 0;
unsigned char BitMap2 = 0;

//MQTT publishing periodicity of system info, in msecs
unsigned long PublishPeriod = 30000;

//***EEPROM addresses where variables are stored***
int eePh_RegulationOnOff_Address = 0;
int eeOrp_RegulationOnOff_Address = eePh_RegulationOnOff_Address + sizeof(byte);
int eePh_SetPoint_Address = eeOrp_RegulationOnOff_Address + sizeof(byte);
int eeOrp_SetPoint_Address = eePh_SetPoint_Address + sizeof(double);
int eeWaterTempLowThreshold_Address = eeOrp_SetPoint_Address + sizeof(double);
int eeWaterTemp_SetPoint_Address = eeWaterTempLowThreshold_Address + sizeof(float);
int eePh_Kp_Address = eeWaterTemp_SetPoint_Address + sizeof(float);
int eePh_Ki_Address = eePh_Kp_Address + sizeof(double);
int eePh_Kd_Address = eePh_Ki_Address + sizeof(double);
int eeOrp_Kp_Address = eePh_Kd_Address + sizeof(double);
int eeOrp_Ki_Address = eeOrp_Kp_Address + sizeof(double);
int eeOrp_Kd_Address = eeOrp_Ki_Address + sizeof(double);
int eeFiltStartAddress = eeOrp_Kd_Address + sizeof(double);
int eeFiltStopAddress = eeFiltStartAddress + sizeof(unsigned int);
int eePubPeriodAddress = eeFiltStopAddress + sizeof(unsigned int);
int eePhPIDWindowAddress = eePubPeriodAddress + sizeof(unsigned long);
int eeOrpPIDWindowAddress = eePhPIDWindowAddress + sizeof(unsigned long);
int eePhPumpUpTimeLimitAddress = eeOrpPIDWindowAddress + sizeof(unsigned long);
int eeChlPumpUpTimeLimitAddress = eePhPumpUpTimeLimitAddress + sizeof(unsigned int);
int eepHCalibCoeff0Address = eeChlPumpUpTimeLimitAddress + sizeof(unsigned int);
int eepHCalibCoeff1Address = eepHCalibCoeff0Address + sizeof(float);
int eeOrpCalibCoeff0Address = eepHCalibCoeff1Address + sizeof(float);
int eeOrpCalibCoeff1Address = eeOrpCalibCoeff0Address + sizeof(float);

// Data wire is connected to input digital pin 20 on the Arduino
#define ONE_WIRE_BUS_A 20

// Setup a oneWire instance to communicate with any OneWire devices
OneWire oneWire_A(ONE_WIRE_BUS_A);

// Pass our oneWire reference to Dallas Temperature library instance 
DallasTemperature sensors_A(&oneWire_A);

//12bits (0,06°C) temperature sensor resolution
#define TEMPERATURE_RESOLUTION 12

//Signal filtering library. Only used in this case to compute the average
//over multiple measurements but offers other filtering functions such as median, etc. 
RunningMedian samples_Temp = RunningMedian(15);
RunningMedian samples_Ph = RunningMedian(15);
RunningMedian samples_Orp = RunningMedian(15);

//MAC Address of DS18b20 water temperature sensor
DeviceAddress DS18b20_0 = { 0x28, 0x92, 0x25, 0x41, 0x0A, 0x00, 0x00, 0xEE };
String sDS18b20_0 = "";

// MAC address of Ethernet shield (in case of Controllino board, set an arbitrary MAC address)
byte mac[] = { 0xDE, 0xAD, 0xBE, 0xEF, 0xFE, 0xED };
String sArduinoMac = "";
IPAddress ip(192, 168, 0, 21);  //IP address, needs to be adapted depending on local network topology
EthernetServer server(80);      //Create a server at port 80
EthernetClient net;             //Ethernet client to connect to MQTT server

//MQTT stuff including local broker/server IP address, login and pwd
MQTTClient MQTTClient;
const char* MqttServerIP = "192.168.0.41";
const char* MqttServerClientID = "ArduinoPool2"; // /!\ choose a client ID which is unique to this Arduino board
const char* MqttServerLogin = "admin";
const char* MqttServerPwd = "admin";
const char* PoolTopic = "Home/Pool";
const char* PoolTopicAPI = "Home/Pool/API";
const char* PoolTopicStatus = "Home/Pool/status";

//Date-Time variables for use with internal RTC (Real Time Clock) module
unsigned char day, weekday, month, year, hour, minute, sec;
char TimeBuffer[25];

//serial printing stuff
String _endl = "\n";

//State Machine
//Getting a 12 bits temperature reading on a DS18b20 sensor takes >750ms
//Here we use the sensor in asynchronous mode, request a temp reading and use
//the nice "YASM" state-machine library to do other things while it is being obtained
YASM gettemp;

//Callbacks
//Here we use the SoftTimer library which handles multiple timers (Tasks)
//It is more elegant and readable than a single loop() functtion, especially
//when tasks with various frequencies are to be used
void EthernetClientCallback(Task* me);
void OrpRegulationCallback(Task* me);
void PHRegulationCallback(Task* me);
void GenericCallback(Task* me);
void PublishDataCallback(Task* me);

Task t1(500, EthernetClientCallback);         //Check for Ethernet client every 0.5 secs
Task t2(1000, OrpRegulationCallback);         //ORP regulation loop every 1 sec
Task t3(1100, PHRegulationCallback);          //PH regulation loop every 1.1 sec
Task t4(30000, PublishDataCallback);          //Publish data to MQTT broker every 30 secs
Task t5(600, GenericCallback);                //Various things handled/updated in this loop every 0.6 secs


void setup()
{
    // set up the LCD's number of columns and rows:
    lcd.begin(20, 4);
    lcd.clear();
  
    //RTC Stuff (embedded battery operated clock)
    Controllino_RTC_init(0);
    Controllino_ReadTimeDate(&day,&weekday,&month,&year,&hour,&minute,&sec);

    //Define pins directions
    pinMode(FILTRATION_PUMP, OUTPUT);
    pinMode(PH_PUMP, OUTPUT);
    pinMode(CHL_PUMP, OUTPUT);

    pinMode(CHL_LEVEL, INPUT_PULLUP);
    pinMode(PH_LEVEL, INPUT_PULLUP);

    pinMode(ORP_MEASURE, INPUT);
    pinMode(PH_MEASURE, INPUT);

    //String for MAC address of Ethernet shield for the log & XML file
    sArduinoMac = F("0xDE, 0xAD, 0xBE, 0xEF, 0xFE, 0xED");

    //Serial port for debug info
    Serial.begin(9600);

    //8 seconds watchdog timer to reset system in case it freezes for more than 8 seconds
    wdt_enable(WDTO_8S);
   
    //Restore variables stored into EEPROM
    RestoreVariables();
    
    // initialize Ethernet device   
    Ethernet.begin(mac, ip);  
    
    // start to listen for clients
    server.begin();  
   
    //Start temperature measurement state machine
    gettemp.next(gettemp_start);

    //Init MQTT
    MQTTClient.setOptions(60,true,10000);
    MQTTClient.setWill(PoolTopicStatus,"offline",true,LWMQTT_QOS1);
    MQTTClient.begin(MqttServerIP, net);
    MQTTClient.onMessage(messageReceived);
    MQTTConnect();
   
    //Initialize PIDs
    PhPIDwindowStartTime = millis();
    OrpPIDwindowStartTime = millis();

    //tell the PIDs to range their Output between 0 and the full window size
    PhPID.SetTunings(Ph_Kp, Ph_Ki, Ph_Kd);
    PhPID.SetOutputLimits(0, PhPIDWindowSize);
    OrpPID.SetTunings(Orp_Kp, Orp_Ki, Orp_Kd);
    OrpPID.SetOutputLimits(0, OrpPIDWindowSize);

    //let the PIDs off at start
    SetPhPID(false);
    SetOrpPID(false);

    //Initialize Filtration
    FiltrationDuration = 12;
    FiltrationStop = FiltrationStart + FiltrationDuration;
        
    //Ethernet client check loop
    SoftTimer.add(&t1);

    //Orp regulation loop
    SoftTimer.add(&t2);

    //PH regulation loop
    SoftTimer.add(&t3);

    //Publish loop
    SoftTimer.add(&t4);

    //Generic loop
    SoftTimer.add(&t5);

    //display remaining RAM space. For debug
    Serial<<F("[memCheck]: ")<<freeRam()<<F("b")<<_endl;
}

//Connect to MQTT broker and subscribe to the PoolTopicAPI topic in order to receive future commands
//then publish the "online" message on the "status" topic. If Ethernet connection is ever lost
//"status" will switch to "offline". Very useful to check that the Arduino is alive and functional
void MQTTConnect() 
{
  Serial<<F("connecting to MQTT server...");
  while (!MQTTClient.connect(MqttServerClientID, MqttServerLogin, MqttServerPwd))
  {
    Serial<<F(".")<<_endl;
    delay(1000);
  }
  
  //String PoolTopicAPI = "Home/Pool/Api";
  //Topic to which send/publish API commands for the Pool controls
  MQTTClient.subscribe(PoolTopicAPI);

  //tell status topic we are online
  if(MQTTClient.publish(PoolTopicStatus,"online",true,LWMQTT_QOS1))
      Serial<<F("published: Home/Pool/status - online")<<_endl;
}

//MQTT callback
//This function is called when messages are published on the MQTT broker on the PoolTopicAPI topic to which we subscribed
//Go through the message payload, check if we understand the content and act accordingly
void messageReceived(String &topic, String &payload) 
{
  String TmpStrPool(PoolTopicAPI);

  //Pool commands. This check might be redundant since we only subscribed to this topic
  if(topic == TmpStrPool)
  {
      //Json buffer
      StaticJsonBuffer<PayloadBufferLength> jsonBuffer;
      
      //Parse Json object and find which command it is
      JsonObject& command = jsonBuffer.parseObject(payload);
      
      // Test if parsing succeeds.
      if (!command.success()) 
      {
        Serial<<F("Json parseObject() failed");
        return;
      }
      else
      {
        Serial<<F("Json parseObject() success - ")<<endl;

        //"PhCalib" command which computes and sets the calibration coefficients of the pH sensor response based on a multi-point linear regression
        //{"PhCalib":[4.02,3.8,9.0,9.11]}  -> multi-point linear regression calibration (minimum 1 point-couple, 6 max.) in the form [ProbeReading_0, BufferRating_0, xx, xx, ProbeReading_n, BufferRating_n]
        if (command.containsKey(F("PhCalib")))
        {
          float CalibPoints[12];//Max six calibration point-couples! Should be plenty enough
          int NbPoints = command["PhCalib"].as<JsonArray>().copyTo(CalibPoints);
          Serial<<F("PhCalib command - ")<<NbPoints<<F(" points received: ");
          for(int i=0;i<NbPoints;i+=2)
            Serial<<CalibPoints[i]<<F(",")<<CalibPoints[i+1]<<F(" - ");
          Serial<<_endl;

          if(NbPoints == 2)//Only one pair of points. Perform a simple offset calibration
          {
            Serial<<F("2 points. Performing a simple offset calibration")<<_endl;

            //compute offset correction
            pHCalibCoeffs[1] += CalibPoints[1] - CalibPoints[0];

            //Store the new coefficients in eeprom
            if((pHCalibCoeffs[1]>-5.0) && (pHCalibCoeffs[1]<5.0)) EEPROM.put( eepHCalibCoeff1Address, pHCalibCoeffs[1]);
          }
          else
          if((NbPoints>3) && (NbPoints%2 == 0))//we have at least 4 points as well as an even number of points. Perform a linear regression calibration
          {         
            Serial<<NbPoints/2<<F(" points. Performing a linear regression calibration")<<_endl;

            float xCalibPoints[NbPoints/2];
            float yCalibPoints[NbPoints/2];

            //generate array of x sensor values (in volts) and y rated buffer values
            //PhValue = (pHCalibCoeffs[0] * ph_sensor_value) + pHCalibCoeffs[1];
            for(int i=0;i<NbPoints;i+=2)
            {
              xCalibPoints[i/2] = (CalibPoints[i] - pHCalibCoeffs[1])/pHCalibCoeffs[0];
              yCalibPoints[i/2] = CalibPoints[i+1];
            }

            //Compute linear regression coefficients
            simpLinReg(xCalibPoints, yCalibPoints, pHCalibCoeffs, NbPoints/2);

            //Store the new coefficients in eeprom
            if((pHCalibCoeffs[0]<10.0) && (pHCalibCoeffs[0]>0.0)) EEPROM.put( eepHCalibCoeff0Address, pHCalibCoeffs[0]);
            if((pHCalibCoeffs[1]>-5.0) && (pHCalibCoeffs[1]<5.0)) EEPROM.put( eepHCalibCoeff1Address, pHCalibCoeffs[1]);
            
            Serial<<F("Calibration completed. Coeffs are: ")<<pHCalibCoeffs[0]<<F(",")<<pHCalibCoeffs[1]<<_endl;   
          }  
        }
        else
        //"OrpCalib" command which computes and sets the calibration coefficients of the Orp sensor response based on a multi-point linear regression
        //{"OrpCalib":[450,465,750,784]}   -> multi-point linear regression calibration (minimum 1 point-couple, 6 max.) in the form [ProbeReading_0, BufferRating_0, xx, xx, ProbeReading_n, BufferRating_n]
        if (command.containsKey(F("OrpCalib")))
        {
          float CalibPoints[12];//Max six calibration point-couples! Should be plenty enough
          int NbPoints = command["OrpCalib"].as<JsonArray>().copyTo(CalibPoints);
          Serial<<F("OrpCalib command - ")<<NbPoints<<F(" points received: ");
          for(int i=0;i<NbPoints;i+=2)
            Serial<<CalibPoints[i]<<F(",")<<CalibPoints[i+1]<<F(" - ");
          Serial<<_endl;

          if(NbPoints == 2)//Only one pair of points. Perform a simple offset calibration
          {
            Serial<<F("2 points. Performing a simple offset calibration")<<_endl;

            //compute offset correction
            OrpCalibCoeffs[1] += CalibPoints[1] - CalibPoints[0];

            //Store the new coefficients in eeprom
            if((OrpCalibCoeffs[1]>1000.0) && (OrpCalibCoeffs[1]<4000.0)) EEPROM.put( eeOrpCalibCoeff1Address, OrpCalibCoeffs[1]);
          }
          else
          if((NbPoints>3) && (NbPoints%2 == 0))//we have at least 4 points as well as an even number of points. Perform a linear regression calibration
          {         
            Serial<<NbPoints/2<<F(" points. Performing a linear regression calibration")<<_endl;

            float xCalibPoints[NbPoints/2];
            float yCalibPoints[NbPoints/2];

            //generate array of x sensor values (in volts) and y rated buffer values
            //OrpValue = (OrpCalibCoeffs[0] * orp_sensor_value) + OrpCalibCoeffs[1]; 
            for(int i=0;i<NbPoints;i+=2)
            {
              xCalibPoints[i/2] = (CalibPoints[i] - OrpCalibCoeffs[1])/OrpCalibCoeffs[0];
              yCalibPoints[i/2] = CalibPoints[i+1];
            }

            //Compute linear regression coefficients
            simpLinReg(xCalibPoints, yCalibPoints, OrpCalibCoeffs, NbPoints/2);

            //Store the new coefficients in eeprom
            if((OrpCalibCoeffs[0]>-3000.0) && (OrpCalibCoeffs[0]<-500.0)) EEPROM.put( eeOrpCalibCoeff0Address, OrpCalibCoeffs[0]);
            if((OrpCalibCoeffs[1]>1000.0) && (OrpCalibCoeffs[1]<4000.0)) EEPROM.put( eeOrpCalibCoeff1Address, OrpCalibCoeffs[1]);
           
            Serial<<F("Calibration completed. Coeffs are: ")<<OrpCalibCoeffs[0]<<F(",")<<OrpCalibCoeffs[1]<<_endl;   
          }   
        }
        else //"Mode" command which sets regulation and filtration to manual or auto modes
        if (command.containsKey(F("Mode")))
        {
            if((int)command[F("Mode")]==0)
            {
              AutoMode = 0;
              
              //Stop PIDs
              //SetPhPID(false);
              //SetOrpPID(false);
            }
            else
            {
              AutoMode = 1;
              
              //Start PIDs
              //SetPhPID(true);
              //SetOrpPID(true);           
            }
        }
        else 
        if (command.containsKey(F("FiltPump"))) //"FiltPump" command which starts or stops the filtration pump
        {
            //Serial<<F("starting Filtration")<<endl;
            if((int)command[F("FiltPump")]==0)
            {
              FiltrationPump(false);  //stop filtration pump
              
              //If auto mode, switch to manual mode
              if(AutoMode)
              {
                AutoMode = 0; 
                
                //Stop PIDs
                SetPhPID(false);
                SetOrpPID(false);
              }
            }
            else
              FiltrationPump(true);   //start filtration pump
        }
        else  
        if(command.containsKey(F("PhPump")))//"PhPump" command which starts or stops the Acid pump
        {          
            if((int)command[F("PhPump")]==0)
              PhPump(false);          //stop Acid pump
            else
              PhPump(true);           //start Acid pump
        } 
        else
        if(command.containsKey(F("ChlPump")))//"ChlPump" command which starts or stops the Acid pump
        {          
            if((int)command[F("ChlPump")]==0)
              ChlPump(false);          //stop Chl pump
            else
              ChlPump(true);           //start Chl pump
        } 
        else
        if(command.containsKey(F("PhPID")))//"PhPID" command which starts or stops the Ph PID loop
        {          
            if((int)command[F("PhPID")]==0)
            {                
              //Stop PID
              SetPhPID(false);
            }
            else
            {
              //Start PID
              SetPhPID(true);
            }
        } 
        else
        if(command.containsKey(F("OrpPID")))//"OrpPID" command which starts or stops the Orp PID loop
        {          
            if((int)command[F("OrpPID")]==0)
            {    
              //Stop PID
              SetOrpPID(false);
            }
            else
            {      
              //Start PID
              SetOrpPID(true);           
            }
        }  
        else  
        if(command.containsKey(F("PhSetPoint")))//"PhSetPoint" command which sets the setpoint for Ph
        {          
           Ph_SetPoint = (float)command[F("PhSetPoint")];
           EEPROM.put( eePh_SetPoint_Address, Ph_SetPoint);
        } 
        else
        if(command.containsKey(F("OrpSetPoint")))//"OrpSetPoint" command which sets the setpoint for ORP
        {          
           Orp_SetPoint = (float)command[F("OrpSetPoint")];
           EEPROM.put( eeOrp_SetPoint_Address, Orp_SetPoint);
        }       
        else 
        if(command.containsKey(F("WSetPoint")))//"WSetPoint" command which sets the setpoint for Water temp (currently not in use)
        {          
           WaterTemp_SetPoint = (float)command[F("WSetPoint")];
           EEPROM.put( eeWaterTemp_SetPoint_Address, WaterTemp_SetPoint);
        }   
        else
        if(command.containsKey(F("WTempLow")))//"WTempLow" command which sets the setpoint for Water temp low threshold
        {          
           WaterTempLowThreshold = (float)command[F("WTempLow")];
           EEPROM.put( eeWaterTempLowThreshold_Address, WaterTempLowThreshold);
        }
        else 
        if(command.containsKey(F("PumpsMaxUp")))//"PumpsMaxUp" command which sets the Max UpTime for pumps
        {          
           PhPumpUpTimeLimit = (unsigned int)command[F("PumpsMaxUp")];
           ChlPumpUpTimeLimit = (unsigned int)command[F("PumpsMaxUp")];
           EEPROM.put( eePhPumpUpTimeLimitAddress, PhPumpUpTimeLimit);
           EEPROM.put( eeChlPumpUpTimeLimitAddress, ChlPumpUpTimeLimit);
        }
        else
        if(command.containsKey(F("OrpPIDParams")))//"OrpPIDParams" command which sets the Kp, Ki and Kd values for Orp PID loop
        {          
           Orp_Kp = (double)command[F("OrpPIDParams")][0];
           Orp_Ki = (double)command[F("OrpPIDParams")][1];
           Orp_Kd = (double)command[F("OrpPIDParams")][2];
           EEPROM.put( eeOrp_Kp_Address, Orp_Kp);
           EEPROM.put( eeOrp_Ki_Address, Orp_Ki);
           EEPROM.put( eeOrp_Kd_Address, Orp_Kd);
           OrpPID.SetTunings(Orp_Kp, Orp_Ki, Orp_Kd);
        }
        else 
        if(command.containsKey(F("PhPIDParams")))//"PhPIDParams" command which sets the Kp, Ki and Kd values for Ph PID loop
        {          
           Ph_Kp = (double)command[F("PhPIDParams")][0];
           Ph_Ki = (double)command[F("PhPIDParams")][1];
           Ph_Kd = (double)command[F("PhPIDParams")][2];
           EEPROM.put( eePh_Kp_Address, Ph_Kp);
           EEPROM.put( eePh_Ki_Address, Ph_Ki);
           EEPROM.put( eePh_Kd_Address, Ph_Kd);
           PhPID.SetTunings(Ph_Kp, Ph_Ki, Ph_Kd);
        }
        else
        if(command.containsKey(F("OrpPIDWSize")))//"OrpPIDWSize" command which sets the window size of the Orp PID loop
        {          
           OrpPIDWindowSize = (unsigned long)command[F("OrpPIDWSize")];
           EEPROM.put( eeOrpPIDWindowAddress, OrpPIDWindowSize);
        }
        else
        if(command.containsKey(F("PhPIDWSize")))//"PhPIDWSize" command which sets the window size of the Ph PID loop
        {          
           PhPIDWindowSize = (unsigned long)command[F("PhPIDWSize")];
           EEPROM.put( eePhPIDWindowAddress, PhPIDWindowSize);
        }
        else
        if(command.containsKey(F("Date")))//"Date" command which sets the Date of RTC module
        {         
           Controllino_SetTimeDate((unsigned char)command[F("Date")][0],(unsigned char)command[F("Date")][1],(unsigned char)command[F("Date")][2],(unsigned char)command[F("Date")][3],(unsigned char)command[F("Date")][4],(unsigned char)command[F("Date")][5],(unsigned char)command[F("Date")][6]); // set initial values to the RTC chip. (Day of the month, Day of the week, Month, Year, Hour, Minute, Second)
        }
        else
        if(command.containsKey(F("FiltT0")))//"FiltT0" command which sets the earliest hour when starting Filtration pump
        {          
           FiltrationStart = (unsigned int)command[F("FiltT0")];
           EEPROM.put( eeFiltStartAddress, FiltrationStart);
        }
        else 
        if(command.containsKey(F("FiltT1")))//"FiltT1" command which sets the latest hour for running Filtration pump
        {          
           FiltrationStopMax = (unsigned int)command[F("FiltT1")];
           EEPROM.put( eeFiltStopAddress, FiltrationStopMax);
        }
        else
        if(command.containsKey(F("PubPeriod")))//"PubPeriod" command which sets the periodicity for publishing system info to MQTT broker
        {    
          PublishPeriod = (unsigned long)command[F("PubPeriod")]*1000; //in secs
          t4.setPeriodMs(PublishPeriod); //in msecs
          EEPROM.put( eePubPeriodAddress, PublishPeriod);
        }
        else
        if(command.containsKey(F("Clear")))//"Clear" command which clears the UpTime errors of the Pumps
        {    
          //add 30mins to the UpTimeLimit
          ChlPumpUpTimeLimit += 1800;
          PhPumpUpTimeLimit += 1800;
          PhUpTimeError = 0;
          ChlUpTimeError = 0;
        }
                    
        //Publish/Update on the MQTT broker the status of our variables
        PublishDataCallback(NULL);    
      }       
  }
}

//Loop where various tasks are updated/handled
void GenericCallback(Task* me)
{
    //clear watchdog timer
    wdt_reset();
    //Serial<<F("Watchdog Reset")<<_endl;

    //request temp reading
    gettemp.run();

    //Update MQTT thread
    MQTTClient.loop(); 

    //reset time counters at midnight
    //And compute next Filtering duration and stop time (in hours)
    if((hour == 0) && (minute == 0))
    {
      FiltrationPumpTimeCounter = 0;
      PhPumpTimeCounter = 0; 
      ChlPumpTimeCounter = 0;  
      EEPROM.get( eePhPumpUpTimeLimitAddress, uiVar); if((uiVar>0) && (uiVar<7200)) PhPumpUpTimeLimit = uiVar; 
      EEPROM.get( eeChlPumpUpTimeLimitAddress, uiVar); if((uiVar>0) && (uiVar<7200)) ChlPumpUpTimeLimit = uiVar; 
      FiltrationDuration = round(TempValue/2);
      if(FiltrationDuration<3) FiltrationDuration = 3;
      FiltrationStop = FiltrationStart + FiltrationDuration;
      Serial<<F("FiltrationDuration: ")<<FiltrationDuration<<_endl; 
      if(FiltrationStop>FiltrationStopMax)
        FiltrationStop=FiltrationStopMax;
    }

    //start filtration pump as scheduled
    if(AutoMode && (!digitalRead(FILTRATION_PUMP)) && (hour >= FiltrationStart) && (hour < FiltrationStop))
        FiltrationPump(true);

    //stop filtration pump as scheduled
    if(AutoMode && digitalRead(FILTRATION_PUMP) && ((hour < FiltrationStart) || (hour >= FiltrationStop)))
        FiltrationPump(false); 

    //Update LCD display
    LCDUpdate();
}

//PublishData loop. Publishes system info/data to MQTT broker every XX secs (30 secs by default)
void PublishDataCallback(Task* me)
{      
     //Check and update pumps metrics
      UpdatePumpMetrics();
    
     //Store the GPIO states in one Byte (more efficient over MQTT)
      EncodeBitmap();
      
      if (!MQTTClient.connected()) 
      {
        MQTTConnect();
        //Serial.println("MQTT reconnecting...");
      }

      //send a JSON to MQTT broker. /!\ Split JSON if longer than 128 bytes
      //Will publish something like {"Tmp":818,"pH":321,"pHEr":0,"Orp":583,"OrpEr":0,"FilUpT":8995,"PhUpT":0,"ChlUpT":0,"IO":11,"IO2":0}
      StaticJsonBuffer<200> jsonBuffer;
      JsonObject& root = jsonBuffer.createObject();

      root.set<int>("Tmp", (int)(TempValue*100));
      root.set<int>("pH", (int)(PhValue*100));
      root.set<unsigned long>("pHEr", (unsigned long)(PhPIDOutput/100));
      root.set<int>("Orp", (int)OrpValue);
      root.set<unsigned long>("OrpEr", (unsigned long)(OrpPIDOutput/100));
      root.set<unsigned long>("FilUpT", FiltrationPumpTimeCounter);
      root.set<unsigned long>("PhUpT", PhPumpTimeCounter);
      root.set<unsigned long>("ChlUpT", ChlPumpTimeCounter);
      root.set<unsigned char>("IO", BitMap);
      root.set<unsigned char>("IO2", BitMap2);

      //char Payload[PayloadBufferLength];
      if(jsonBuffer.size() < PayloadBufferLength)
      {
        root.printTo(Payload,PayloadBufferLength);
        MQTTClient.publish(PoolTopic,Payload,strlen(Payload),false,LWMQTT_QOS1);
        
        Serial<<F("Payload: ")<<Payload<<F(" - ");
        Serial<<F("Payload size: ")<<jsonBuffer.size()<<_endl;   
      }
      else
      {
        Serial<<F("MQTT Payload buffer overflow! - ");
        Serial<<F("Payload size: ")<<jsonBuffer.size()<<_endl;  
      }
        
/*  
      //clear the buffer
      memset(Payload, 0, sizeof(Payload));
      
      char *p = &Payload[0];
      p += sprintf(p, "{\"Tmp\":%d",(int)(TempValue*100));
      p += sprintf(p, ",\"pH\":%d",(int)(PhValue*100));
      p += sprintf(p, ",\"pHEr\":%d",(unsigned long)(PhPIDOutput/100));
      p += sprintf(p, ",\"Orp\":%d",(int)OrpValue);
      p += sprintf(p, ",\"OrpEr\":%d",(unsigned long)(OrpPIDOutput/100));    
      p += sprintf(p, ",\"FilUpT\":%d",FiltrationPumpTimeCounter);
      p += sprintf(p, ",\"PhUpT\":%d",PhPumpTimeCounter);
      p += sprintf(p, ",\"ChlUpT\":%d",ChlPumpTimeCounter);
      p += sprintf(p, ",\"IO\":%u",BitMap);
      p += sprintf(p, ",\"IO2\":%u}",BitMap2);

      //Payload length to send out
      int PayloadLength = strlen(Payload);

     if(PayloadLength < PayloadBufferLength)
      {
        //call it to delete undesired persistent messages 
        //MQTTClient.publish(PoolTopic,new byte[0], 0,false,LWMQTT_QOS1);
        
        MQTTClient.publish(PoolTopic,Payload,PayloadLength,false,LWMQTT_QOS1);
        Serial<<F("MQTT published on PoolTopic: ")<<Payload<<_endl; 
      }
      else
        Serial<<F("MQTT Payload buffer overflow!")<<_endl;*/
}

void PHRegulationCallback(Task* me)
{
  //Make sure filtration pump is running if regulating, otherwise stop regulation
/*  
 if(AutoMode && digitalRead(FILTRATION_PUMP))
  {
    //if PID is not running, start it
    if(PhPID.GetMode() == 0) 
    {
      PhPID.SetTunings(Ph_Kp, Ph_Ki, Ph_Kd);
      PhPID.SetMode(1);
      Ph_RegulationOnOff = 1;
    }
*/

 //do not compute PID if filtration pump is not running
 //because if Ki was non-zero that would let the OutputError increase
 if(digitalRead(FILTRATION_PUMP))
  {
    PhPID.Compute(); 
  
   /************************************************
   * turn the Acid pump on/off based on pid output
   ************************************************/
    if (millis() - PhPIDwindowStartTime > PhPIDWindowSize)
    { 
      //time to shift the Relay Window
      PhPIDwindowStartTime += PhPIDWindowSize;
    }
    if (PhPIDOutput < millis() - PhPIDwindowStartTime)
      PhPump(false);
    else 
      PhPump(true);
  }
}

//Orp regulation loop
void OrpRegulationCallback(Task* me)
{
  //Make sure filtration pump is running if regulating, otherwise stop regulation
/*  if(AutoMode && digitalRead(FILTRATION_PUMP))
  {
    //if PID is not running, start it
    if(OrpPID.GetMode() == 0) 
    {
      OrpPID.SetTunings(Orp_Kp, Orp_Ki, Orp_Kd);
      OrpPID.SetMode(1);
      Orp_RegulationOnOff = 1;
    }
    */
  //do not compute PID if filtration pump is not running
  //because if Ki was non-zero that would let the OutputError increase
  if(digitalRead(FILTRATION_PUMP))
  {
    OrpPID.Compute(); 
  
   /************************************************
   * turn the Acid pump on/off based on pid output
   ************************************************/
    if (millis() - OrpPIDwindowStartTime > OrpPIDWindowSize)
    { 
      //time to shift the Relay Window
      OrpPIDwindowStartTime += OrpPIDWindowSize;
    }
    if (OrpPIDOutput < millis() - OrpPIDwindowStartTime)
      ChlPump(false);
    else 
      ChlPump(true);
  }
}

//Enable/Disable Chl PID
void SetPhPID(bool Enable)
{
  if(Enable)
  {
     //Stop PhPID
     PhUpTimeError = 0;
     PhPIDOutput = 0.0;
     PhPID.SetMode(1);
     Ph_RegulationOnOff = 1;
  }
  else
  {
     //Stop PhPID
     PhPID.SetMode(0);
     Ph_RegulationOnOff = 0;
     PhPIDOutput = 0.0;   
     PhPump(false);
  }
}

//Enable/Disable Orp PID
void SetOrpPID(bool Enable)
{
  if(Enable)
  {
     //Stop OrpPID
     ChlUpTimeError = 0;
     OrpPIDOutput = 0.0;
     OrpPID.SetMode(1);
     Orp_RegulationOnOff = 1;

  }
  else
  {
     //Stop OrpPID
     OrpPID.SetMode(0);
     Orp_RegulationOnOff = 0;
     OrpPIDOutput = 0.0;   
     ChlPump(false);
  }
}

//Encode digital inputs states into one Byte (more efficient to send over MQTT)
void EncodeBitmap()
{
    BitMap = 0;
    BitMap2 = 0;
    BitMap |= (digitalRead(FILTRATION_PUMP) & 1) << 7;
    BitMap |= (digitalRead(PH_PUMP) & 1) << 6;
    BitMap |= (digitalRead(CHL_PUMP) & 1) << 5;
    BitMap |= (digitalRead(PH_LEVEL) & 1) << 4;
    BitMap |= (digitalRead(CHL_LEVEL) & 1) << 3;
    BitMap |= (AutoMode & 1) << 2;
    BitMap |= (PhUpTimeError & 1) << 1;
    BitMap |= (ChlUpTimeError & 1) << 0;
    
    BitMap2 |= (PhPID.GetMode() & 1) << 7;
    BitMap2 |= (OrpPID.GetMode() & 1) << 6;
}

//Check and update pumps time metrics
void UpdatePumpMetrics()
{
      //If ChlPump running, update the UpTime
      if(digitalRead(CHL_PUMP))
      {
        ChlPumpTimeCounter += ((millis() - ChlPumpTimeCounterStart)/1000); 
        ChlPumpTimeCounterStart = millis();
      }
  
      //If PhPump running, update the UpTime
      if(digitalRead(PH_PUMP))
      {
        PhPumpTimeCounter += ((millis() - PhPumpTimeCounterStart)/1000); 
        PhPumpTimeCounterStart = millis();
      }
  
      //If FiltPump running, update the UpTime
      if(digitalRead(FILTRATION_PUMP))
      {
        FiltrationPumpTimeCounter += ((millis() - FiltrationPumpTimeCounterStart)/1000); 
        FiltrationPumpTimeCounterStart = millis();
      }
  
      //If Ph pum has been runing for too long over the current 24h period OR tank levels are low, stop Ph PID regulations
      if (((PhPumpTimeCounter) > PhPumpUpTimeLimit) || !digitalRead(PH_LEVEL))
      {
        //AutoMode = 0;
        
        //Stop PhPID
        SetPhPID(false);
        SetOrpPID(false);
  
        //Raise error flag
        PhUpTimeError = 1;
        ChlUpTimeError = 1;
      }
  
      //If Chl pump has been runing for too long over the current 24h period, stop Orp PID regulation
      if (((ChlPumpTimeCounter) > ChlPumpUpTimeLimit) || !digitalRead(CHL_LEVEL))
      {
        //AutoMode = 0;
        
        //Stop PhPID
        SetPhPID(false);
        SetOrpPID(false);
  
        //Raise error flag
        PhUpTimeError = 1;
        ChlUpTimeError = 1;
      }
}
    
//Update temperature, Ph and Orp values
void getMeasures(DeviceAddress deviceAddress_0)
{
  Serial<<TimeBuffer<<F(" - ");

  //Water Temperature
  samples_Temp.add(sensors_A.getTempC(deviceAddress_0));
  TempValue = samples_Temp.getAverage(10);
  if (TempValue == -127.00) {
    Serial<<F("Error getting temperature from DS18b20_0")<<_endl;
  } else {
    Serial<<F("DS18b20_0: ")<<TempValue<<F("°C")<<F(" - ");
  }

  //Ph
  float ph_sensor_value = analogRead(PH_MEASURE)* 5000.0 / 1023.0 / 1000.0;                           // from 0.0 to 5.0 V
  //PhValue = 7.0 - ((2.5 - ph_sensor_value)/(0.257179 + 0.000941468 * TempValue));                   // formula to compute pH which takes water temperature into account
  //PhValue = (0.0178 * ph_sensor_value * 200.0) - 1.889;                                             // formula to compute pH without taking temperature into account (assumes 27deg water temp)
  PhValue = (pHCalibCoeffs[0] * ph_sensor_value) + pHCalibCoeffs[1];                                  //Calibrated sensor response based on multi-point linear regression
  samples_Ph.add(PhValue);                                                                            // compute average of pH from last 5 measurements
  PhValue = samples_Ph.getAverage(5);
  Serial<<F("ph_sensor_value: ")<<ph_sensor_value<<F(" - ");
  Serial<<F("PhValue: ")<<PhValue<<F(" - ")<<pHCalibCoeffs[0]<<F(" - ")<<pHCalibCoeffs[1]<<_endl;

  //ORP
  float orp_sensor_value = analogRead(ORP_MEASURE) * 5000.0 / 1023.0 / 1000.0;                        // from 0.0 to 5.0 V
  //OrpValue = ((2.5 - orp_sensor_value) / 1.037) * 1000.0;                                           // from -2000 to 2000 mV where the positive values are for oxidizers and the negative values are for reducers
  OrpValue = (OrpCalibCoeffs[0] * orp_sensor_value) + OrpCalibCoeffs[1];                              //Calibrated sensor response based on multi-point linear regression
  samples_Orp.add(OrpValue);                                                                          // compute average of ORP from last 5 measurements
  OrpValue = samples_Orp.getAverage(5);
  Serial<<F("orp_sensor_value: ")<<orp_sensor_value<<F(" - ");
  Serial<<F("OrpValue: ")<<OrpValue<<F("mV")<<F(" - ")<<OrpCalibCoeffs[0]<<F(" - ")<<OrpCalibCoeffs[1]<<_endl;
}


//Restore variables stored in EEPROM
void RestoreVariables()
{
    //Set variables to their default values in case we fail to retrieve the value stored in EEPROM
    //Enabled/disabled status of the PID regulations
    Ph_RegulationOnOff = 1;      //ON = 1; OFF = 0;
    Orp_RegulationOnOff = 1;     //ON = 1; OFF = 0;

    //Filtration start and stop hours
    FiltrationStart = 8;
    FiltrationStopMax = 20;
    
    //PH and ORP calibration coefficients (slope and offset)
    pHCalibCoeffs[0] = 3.56f;
    pHCalibCoeffs[1] = -1.889f;
    OrpCalibCoeffs[0] = -964.32f;
    OrpCalibCoeffs[1] = 2410.8f;
    
    //PH and ORP Setpoints
    Ph_SetPoint = 7.4f;
    Orp_SetPoint = 750.0f;
    
    //Water temperature low threshold. Stop regulations below this temp (ie. in winter) 
    WaterTempLowThreshold = 10.0f;
    
    //Water temperature setpoint. Currently not in use
    WaterTemp_SetPoint = 27.0f;
    
    //Ph PID constants
    Ph_Kp = 1330000;
    Ph_Ki = 0;
    Ph_Kd = 0;
    
    //Orp PID constants
    Orp_Kp = 2857;
    Orp_Ki = 0;
    Orp_Kd = 0;

    //PID windows
    PhPIDWindowSize =  1800000;//30 mins
    OrpPIDWindowSize = 1800000;//30 mins

    //MQTT publish period
    PublishPeriod = 30000;

    //Pumps max uptime limit (in min) per 24h
    PhPumpUpTimeLimit = 1800;
    ChlPumpUpTimeLimit = 1800;    
 
    //read values stored in EEPROM but check that values make sense. If not use default values and write them into EEPROM
    EEPROM.get( eePh_RegulationOnOff_Address, bVar); if((bVar==0) || (bVar==1)) Ph_RegulationOnOff = (bool)bVar; else EEPROM.put( eePh_RegulationOnOff_Address, Ph_RegulationOnOff);  Serial<<F("Ph_RegulationOnOff: ")<<Ph_RegulationOnOff<<_endl;
    EEPROM.get( eeOrp_RegulationOnOff_Address, bVar); if((bVar==0) || (bVar==1)) Orp_RegulationOnOff = (bool)bVar; else EEPROM.put( eeOrp_RegulationOnOff_Address, Orp_RegulationOnOff);  Serial<<F("Orp_RegulationOnOff: ")<<Orp_RegulationOnOff<<_endl;  
    EEPROM.get( eePh_SetPoint_Address, fVar); if((fVar>5.0f) && (fVar<8.5f)) Ph_SetPoint = fVar; else EEPROM.put( eePh_SetPoint_Address, Ph_SetPoint); Serial<<F("Ph_SetPoint: ")<<Ph_SetPoint<<_endl;
    EEPROM.get( eeOrp_SetPoint_Address, fVar); if((fVar>550.0f) && (fVar<950.0f)) Orp_SetPoint = fVar; else EEPROM.put( eeOrp_SetPoint_Address, Orp_SetPoint); Serial<<F("Orp_SetPoint: ")<<Orp_SetPoint<<_endl;
    EEPROM.get( eeWaterTempLowThreshold_Address, fVar); if((fVar>0.0f) && (fVar<30.0f)) WaterTempLowThreshold = fVar; else EEPROM.put( eeWaterTempLowThreshold_Address, WaterTempLowThreshold); Serial<<F("WaterTempLowThreshold: ")<<WaterTempLowThreshold<<_endl;
    EEPROM.get( eeWaterTemp_SetPoint_Address, fVar); if((fVar>0.0f) && (fVar<40.0f)) WaterTemp_SetPoint = fVar; else EEPROM.put( eeWaterTemp_SetPoint_Address, WaterTemp_SetPoint); Serial<<F("WaterTemp_SetPoint: ")<<WaterTemp_SetPoint<<_endl;
    EEPROM.get( eePh_Kp_Address, fVar); if((fVar>0) && (fVar<100000000.0f)) Ph_Kp = fVar; else EEPROM.put( eePh_Kp_Address, Ph_Kp); Serial<<F("Ph_Kp: ")<<Ph_Kp<<_endl;
    EEPROM.get( eePh_Ki_Address, fVar); if((fVar>0) && (fVar<100000000.0f)) Ph_Ki = fVar; else EEPROM.put( eePh_Ki_Address, Ph_Ki); Serial<<F("Ph_Ki: ")<<Ph_Ki<<_endl;
    EEPROM.get( eePh_Kd_Address, fVar); if((fVar>0) && (fVar<100000000.0f)) Ph_Kd = fVar; else EEPROM.put( eePh_Kd_Address, Ph_Kd); Serial<<F("Ph_Kd: ")<<Ph_Kd<<_endl;
    EEPROM.get( eeOrp_Kp_Address, fVar); if((fVar>0) && (fVar<100000000.0f)) Orp_Kp = fVar; else EEPROM.put( eeOrp_Kp_Address, Orp_Kp); Serial<<F("Orp_Kp: ")<<Orp_Kp<<_endl;
    EEPROM.get( eeOrp_Ki_Address, fVar); if((fVar>0) && (fVar<100000000.0f)) Orp_Ki = fVar; else EEPROM.put( eeOrp_Ki_Address, Orp_Ki); Serial<<F("Orp_Ki: ")<<Orp_Ki<<_endl;
    EEPROM.get( eeOrp_Kd_Address, fVar); if((fVar>0) && (fVar<100000000.0f)) Orp_Kd = fVar; else EEPROM.put( eeOrp_Kd_Address, Orp_Kd); Serial<<F("Orp_Kd: ")<<Orp_Kd<<_endl;
    EEPROM.get( eeFiltStartAddress, uiVar); if((uiVar>0) && (uiVar<24)) FiltrationStart = uiVar; else EEPROM.put( eeFiltStartAddress, FiltrationStart); Serial<<F("FiltrationStart: ")<<FiltrationStart<<_endl;
    EEPROM.get( eeFiltStopAddress, uiVar); if((uiVar>0) && (uiVar<24)) FiltrationStopMax = uiVar; else EEPROM.put( eeFiltStopAddress, FiltrationStopMax); Serial<<F("FiltrationStopMax: ")<<FiltrationStopMax<<_endl;
    EEPROM.get( eePubPeriodAddress, ulVar); if((ulVar>0) && (ulVar<4294966)) PublishPeriod = ulVar; else EEPROM.put( eePubPeriodAddress, PublishPeriod); Serial<<F("PublishPeriod: ")<<PublishPeriod<<_endl; 
    EEPROM.get( eePhPIDWindowAddress, ulVar); if((ulVar>0) && (ulVar<4294966)) PhPIDWindowSize = ulVar; else EEPROM.put( eePhPIDWindowAddress, PhPIDWindowSize); Serial<<F("PhPIDWindowSize: ")<<PhPIDWindowSize<<_endl; 
    EEPROM.get( eeOrpPIDWindowAddress, ulVar); if((ulVar>0) && (ulVar<4294966)) OrpPIDWindowSize = ulVar; else EEPROM.put( eeOrpPIDWindowAddress, OrpPIDWindowSize); Serial<<F("OrpPIDWindowSize: ")<<OrpPIDWindowSize<<_endl; 
    EEPROM.get( eePhPumpUpTimeLimitAddress, uiVar); if((uiVar>0) && (uiVar<7200)) PhPumpUpTimeLimit = uiVar; else EEPROM.put( eePhPumpUpTimeLimitAddress, PhPumpUpTimeLimit); Serial<<F("PhPumpUpTimeLimit: ")<<PhPumpUpTimeLimit<<_endl; 
    EEPROM.get( eeChlPumpUpTimeLimitAddress, uiVar); if((uiVar>0) && (uiVar<7200)) ChlPumpUpTimeLimit = uiVar; else EEPROM.put( eeChlPumpUpTimeLimitAddress, ChlPumpUpTimeLimit); Serial<<F("ChlPumpUpTimeLimit: ")<<ChlPumpUpTimeLimit<<_endl; 
    EEPROM.get( eepHCalibCoeff0Address, fVar); if((fVar<10.0) && (fVar>1.0)) pHCalibCoeffs[0] = fVar; else EEPROM.put( eepHCalibCoeff0Address, pHCalibCoeffs[0]); Serial<<F("pHCalibCoeffs[0]: ")<<pHCalibCoeffs[0]<<_endl; 
    EEPROM.get( eepHCalibCoeff1Address, fVar); if((fVar>-5.0) && (fVar<5.0)) pHCalibCoeffs[1] = fVar; else EEPROM.put( eepHCalibCoeff1Address, pHCalibCoeffs[1]); Serial<<F("pHCalibCoeffs[1]: ")<<pHCalibCoeffs[1]<<_endl;
    EEPROM.get( eeOrpCalibCoeff0Address, fVar); if((fVar>-3000.0) && (fVar<-500.0)) OrpCalibCoeffs[0] = fVar; else EEPROM.put( eeOrpCalibCoeff0Address, OrpCalibCoeffs[0]); Serial<<F("OrpCalibCoeffs[0]: ")<<OrpCalibCoeffs[0]<<_endl; 
    EEPROM.get( eeOrpCalibCoeff1Address, fVar); if((fVar>1000.0) && (fVar<4000.0)) OrpCalibCoeffs[1] = fVar; else EEPROM.put( eeOrpCalibCoeff1Address, OrpCalibCoeffs[1]); Serial<<F("OrpCalibCoeffs[1]: ")<<OrpCalibCoeffs[1]<<_endl;
}

// Print data to the LCD.
void LCDUpdate()
{
  //Concatenate data into one buffer then print it ot the 20x4 LCD
  //!LCD driver wrapps lines in a strange order: line 1, then 3, then 2 then 4
  //Here we reuse the MQTT Payload buffer while it is not being used
  lcd.setCursor(0, 0);
  memset(Payload, 0, sizeof(Payload));
  char *p = &Payload[0];
  char buff2[10];
  char *p2 = &buff2[0];
      
  p += sprintf(p, "Redox:%4dmV  ",(int)OrpValue);
  p2 = ftoa(p2, PhValue, 1);
  p += sprintf(p, "pH:%3s",buff2);
  p += sprintf(p, "pH pump:%2dmn  ",PhPumpTimeCounter/60);
  p += sprintf(p, "Err:%2d",PhUpTimeError);
  memset(buff2, 0, sizeof(buff2));
  p2 = &buff2[0];
  p2 = ftoa(p2, TempValue, 1);
  char deg = 223;//'°' symbol
  p += sprintf(p, "Temp:%5s%cC  ",buff2,deg);
  p += sprintf(p, "Auto:%d",AutoMode);
  p += sprintf(p, "Cl pump:%2dmn  ",ChlPumpTimeCounter/60);
  p += sprintf(p, "Err:%2d",ChlUpTimeError);
  lcd.print(Payload);
}

//Compute free RAM
//useful to check if it does not shrink over time
int freeRam () {
  extern int __heap_start, *__brkval; 
  int v; 
  return (int) &v - (__brkval == 0 ? (int) &__heap_start : (int) __brkval); 
}


////////////////////////gettemp state machine///////////////////////////////////
//Init DS18B20 one-wire library
void gettemp_start()
{
    //String containing MAC address of temp sensor to be written to XML file
    sDS18b20_0 = F("<DS18b20_0 Mac='0x28, 0x92, 0x25, 0x41, 0x0A, 0x00, 0x00, 0xEE'>");
    
    // Start up the library
    sensors_A.begin();
       
    // set the resolution
    sensors_A.setResolution(DS18b20_0, TEMPERATURE_RESOLUTION);

    //don't wait ! Asynchronous mode
    sensors_A.setWaitForConversion(false); 
       
    gettemp.next(gettemp_request);
} 

//Request temperature asynchronously
void gettemp_request()
{
  sensors_A.requestTemperatures();
  gettemp.next(gettemp_wait);
}

//Wait asynchronously for requested temperature measurement
void gettemp_wait()
{ //we need to wait that time for conversion to finish
  if (gettemp.elapsed(1000/(1<<(12-TEMPERATURE_RESOLUTION))))
    gettemp.next(gettemp_read);
}

//read and print temperature measurement
void gettemp_read()
{
    Controllino_ReadTimeDate(&day,&weekday,&month,&year,&hour,&minute,&sec);
    sprintf(TimeBuffer,"%d-%02d-%02d %02d:%02d:%02d",year+2000,month,day,hour,minute,sec);  
    getMeasures(DS18b20_0); 
    gettemp.next(gettemp_request);
}

void FiltrationPump(bool Start)
{
  if(Start && !digitalRead(FILTRATION_PUMP))
    FiltrationPumpTimeCounterStart = (unsigned long)millis();
  else
  if(!Start && digitalRead(FILTRATION_PUMP))
    FiltrationPumpTimeCounter += ((millis() - FiltrationPumpTimeCounterStart)/1000); 
  
  digitalWrite(FILTRATION_PUMP, Start);
}

void PhPump(bool Start)
{
  if(Start && !digitalRead(PH_PUMP) && digitalRead(PH_LEVEL))
    PhPumpTimeCounterStart = (unsigned long)millis();
  else
  if(!Start && digitalRead(PH_PUMP))
    PhPumpTimeCounter += ((millis() - PhPumpTimeCounterStart)/1000); 
  
  digitalWrite(PH_PUMP, Start);
}

void ChlPump(bool Start)
{
  if(Start && !digitalRead(CHL_PUMP) && digitalRead(CHL_LEVEL))
    ChlPumpTimeCounterStart = (unsigned long)millis();
  else
  if(!Start && digitalRead(CHL_PUMP))
    ChlPumpTimeCounter += ((millis() - ChlPumpTimeCounterStart)/1000); 

  digitalWrite(CHL_PUMP, Start);
}

//string (not String!) function to convert float number to string buffer
//because sprintf() function does not support float types on Arduino
char *ftoa(char *a, double f, int precision)
{
 long p[] = {0,10,100,1000,10000,100000,1000000,10000000,100000000};
 
 char *ret = a;
 long heiltal = (long)f;
 itoa(heiltal, a, 10);
 while (*a != '\0') a++;
 *a++ = '.';
 long desimal = abs((long)((f - heiltal) * p[precision]));
 itoa(desimal, a, 10);
 return ret;
}

//Linear regression coefficients calculation function
// pass x and y arrays (pointers), lrCoef pointer, and n.  
//The lrCoef array is comprised of the slope=lrCoef[0] and intercept=lrCoef[1].  n is the length of the x and y arrays.
//http://jwbrooks.blogspot.com/2014/02/arduino-linear-regression-function.html
void simpLinReg(float* x, float* y, float* lrCoef, int n)
{
  // initialize variables
  float xbar=0;
  float ybar=0;
  float xybar=0;
  float xsqbar=0;
  
  // calculations required for linear regression
  for (int i=0; i<n; i++)
  {
    xbar+=x[i];
    ybar+=y[i];
    xybar+=x[i]*y[i];
    xsqbar+=x[i]*x[i];
  }
  
  xbar/=n;
  ybar/=n;
  xybar/=n;
  xsqbar/=n;
  
  // simple linear regression algorithm
  lrCoef[0]=(xybar-xbar*ybar)/(xsqbar-xbar*xbar);
  lrCoef[1]=ybar-lrCoef[0]*xbar;
}

//Ethernet client checking loop (the Web server sending the system webpage to the browser and/or the XML file containing the system info)
//call http://localIP/Info to obtain an XML file containing the system info
void EthernetClientCallback(Task* me)
{
    EthernetClient client = server.available();  // try to get client
    //readString = "";

    if (client) 
    {  // got client?
        boolean currentLineIsBlank = true;
        Serial<<F("GotClient, current line is blank")<<_endl;
        while (client.connected()) 
        {
            if (client.available()) 
            {   // client data available to read
                char c = client.read(); // read 1 byte (character) from client
                // buffer first part of HTTP request in HTTP_req array (string)
                // leave last element in array as 0 to null terminate string (REQ_BUF_SZ - 1)
                //Serial.println(F("GotClient, reading data"));
                //read char by char HTTP request
                if (readString.length() < 100) 
                {
                  //store characters to string
                  readString += c;
                  //Serial<<c;
                }
                //else
                //Serial<<"length over 100";
                
                // last line of client request is blank and ends with \n
                // respond to client only after last line received
                if (c == '\n' && currentLineIsBlank) 
                {
                  // send a standard http response header
                    client<<F("HTTP/1.1 200 OK")<<_endl;
                    //Serial<<"replying HTTP/1.1 200 OK";
                    //Serial.println(F("HTTP/1.1 200 OK"));
                    // remainder of header follows below, depending on if
                    // web page or XML page is requested
                    
                    // Ajax request - send XML file
                    if(readString.indexOf("Info") >0)
                    { //checks for "Info" string
                        // send rest of HTTP header
                        client<<F("Content-Type: text/xml")<<_endl;
                        client<<F("Connection: keep-alive")<<_endl;
                        client<<_endl;
                        Serial.println(F("sending XML file"));
                        // send XML file containing input states
                        XML_response(client);
                        readString=F("");
                        break;
                    } 
                    else
                    {  
                        // web page request
                        // send rest of HTTP header
                        client<<F("Content-Type: text/html")<<_endl;
                        client<<F("Connection: keep-alive")<<_endl;
                        client<<_endl;
                        client<<F("<!DOCTYPE html>")<<_endl;
                        client<<F("<html>")<<_endl;
                            client<<F("<head>")<<_endl; 
                            
                               client<<F("<style>")<<_endl;
                               client<<F("table.blueTable {")<<_endl;
                               client<<F("border: 1px solid #1C6EA4;")<<_endl;
                               client<<F("background-color: #EEEEEE;")<<_endl;
                               client<<F("width: 70\%;")<<_endl;
                               client<<F("text-align: left;")<<_endl;
                               client<<F("border-collapse: collapse;")<<_endl;
                               client<<F("}")<<_endl;
                               client<<F("table.blueTable td, table.blueTable th {")<<_endl;
                               client<<F("border: 1px solid #AAAAAA;")<<_endl;
                               client<<F("padding: 3px 2px;")<<_endl;
                               client<<F("}")<<_endl;
                               client<<F("table.blueTable tbody td {")<<_endl;
                               client<<F("font-size: 14px;")<<_endl;
                               client<<F("}")<<_endl;
                               client<<F("table.blueTable tr:nth-child(even) {")<<_endl;
                               client<<F("background: #D0E4F5;")<<_endl;
                               client<<F("}")<<_endl;
                               client<<F("table.blueTable tfoot td {")<<_endl;
                               client<<F("font-size: 14px;")<<_endl;
                               client<<F("}")<<_endl;
                               client<<F("table.blueTable tfoot .links {")<<_endl;
                               client<<F("text-align: right;")<<_endl;
                               client<<F("}")<<_endl;
                               client<<F("table.blueTable tfoot .links a{")<<_endl;
                               client<<F("display: inline-block;")<<_endl;
                               client<<F("background: #1C6EA4;")<<_endl;
                               client<<F("color: #FFFFFF;")<<_endl;
                               client<<F("padding: 2px 8px;")<<_endl;
                               client<<F("border-radius: 5px;")<<_endl;
                               client<<F("}")<<_endl;
                               client<<F("</style>")<<_endl;
                               client<<F("<title></title>")<<_endl;

                               //Ajax script function which requests the Info XML file 
                               //from the Arduino and populates the web page with it, every two secs
                               client<<F("<script>")<<_endl;
                                client<<F("function GetData()")<<_endl;
                                client<<F("{")<<_endl;
                                    client<<F("nocache = \"&nocache=\" + Math.random() * 1000000;")<<_endl;
                                    client<<F("var request = new XMLHttpRequest();")<<_endl;
                                    client<<F("request.onreadystatechange = function()")<<_endl;
                                    client<<F("{")<<_endl;
                                        client<<F("if (this.readyState == 4) {")<<_endl;
                                            client<<F("if (this.status == 200) {")<<_endl;
                                                client<<F("if (this.responseXML != null) {")<<_endl;
                                                    // extract XML data from XML file
                                                    client<<F("document.getElementById(\"Date\").innerHTML =")<<_endl;
                                                    client<<F("this.responseXML.getElementsByTagName('Date')[0].childNodes[0].nodeValue;")<<_endl;
          
                                                    client<<F("document.getElementById(\"WaterTemp\").innerHTML =")<<_endl;
                                                    client<<F("this.responseXML.getElementsByTagName('DS18b20_0')[0].childNodes[0].nodeValue;")<<_endl;
                                                    client<<F("document.getElementById(\"pH\").innerHTML =")<<_endl;
                                                    client<<F("this.responseXML.getElementsByTagName('Value')[0].childNodes[0].nodeValue;")<<_endl;
                                                    client<<F("document.getElementById(\"ORP\").innerHTML =")<<_endl;
                                                    client<<F("this.responseXML.getElementsByTagName('Value')[1].childNodes[0].nodeValue;")<<_endl;
                                                    client<<F("document.getElementById(\"Filtration\").innerHTML =")<<_endl;
                                                    client<<F("this.responseXML.getElementsByTagName('Pump')[0].childNodes[0].nodeValue;")<<_endl;
                                                    client<<F("document.getElementById(\"FiltStart\").innerHTML =")<<_endl;
                                                    client<<F("this.responseXML.getElementsByTagName('Start')[0].childNodes[0].nodeValue;")<<_endl;
                                                    client<<F("document.getElementById(\"FiltStop\").innerHTML =")<<_endl;
                                                    client<<F("this.responseXML.getElementsByTagName('Stop')[0].childNodes[0].nodeValue;")<<_endl;

                                                    client<<F("document.getElementById(\"pH2\").innerHTML =")<<_endl;
                                                    client<<F("this.responseXML.getElementsByTagName('Value')[0].childNodes[0].nodeValue;")<<_endl;
                                                    client<<F("document.getElementById(\"ORP2\").innerHTML =")<<_endl;
                                                    client<<F("this.responseXML.getElementsByTagName('Value')[1].childNodes[0].nodeValue;")<<_endl;
                                                    client<<F("document.getElementById(\"pHPump\").innerHTML =")<<_endl;
                                                    client<<F("this.responseXML.getElementsByTagName('Pump')[1].childNodes[0].nodeValue;")<<_endl;
                                                    client<<F("document.getElementById(\"ORPPump\").innerHTML =")<<_endl;
                                                    client<<F("this.responseXML.getElementsByTagName('Pump')[2].childNodes[0].nodeValue;")<<_endl;
                                                    client<<F("document.getElementById(\"pHTank\").innerHTML =")<<_endl;
                                                    client<<F("this.responseXML.getElementsByTagName('TankLevel')[0].childNodes[0].nodeValue;")<<_endl;
                                                    client<<F("document.getElementById(\"ORPTank\").innerHTML =")<<_endl;
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
                                                    client<<F("document.getElementById(\"ChlPumpEr\").innerHTML =")<<_endl;
                                                    client<<F("this.responseXML.getElementsByTagName('ChlPumpEr')[0].childNodes[0].nodeValue;")<<_endl; 
                                                    client<<F("document.getElementById(\"pHPT\").innerHTML =")<<_endl;
                                                    client<<F("this.responseXML.getElementsByTagName('UpT')[0].childNodes[0].nodeValue;")<<_endl; 
                                                    client<<F("document.getElementById(\"ChlPT\").innerHTML =")<<_endl;
                                                    client<<F("this.responseXML.getElementsByTagName('UpT')[1].childNodes[0].nodeValue;")<<_endl;
                                                    
          
                                                    client<<F("}")<<_endl;
                                            client<<F("}")<<_endl;
                                        client<<F("}")<<_endl;
                                    client<<F("}")<<_endl;
                                    client<<F("request.open(\"GET\", \"Info\" + nocache, true);")<<_endl;
                                    client<<F("request.send(null);")<<_endl;
                                    client<<F("setTimeout('GetData()', 2000);")<<_endl;
                                client<<F("}")<<_endl;
                               client<<F("</script>")<<_endl;
            
                            client<<F("</head>")<<_endl;
                            client<<F("<body onload=\"GetData()\">")<<_endl;
                            client<<F("<h1>Pool Master</h1>")<<_endl; 
                            client<<F("<h3><span id=\"Date\">...</span></h3>")<<_endl<<_endl; 
                  
                            //First table: Water temp, pH and ORP values
                            client<<F("<table class=\"blueTable\">")<<_endl;
                            client<<F("<tbody>")<<_endl;
                            client<<F("<tr>")<<_endl;
                            client<<F("<td>Water temp. (deg): <span id=\"WaterTemp\">...</span></td>")<<_endl;
                            client<<F("<td>pH: <span id=\"pH\">...</span></td>")<<_endl;
                            client<<F("<td>ORP (mV): <span id=\"ORP\">...</span></td>")<<_endl;
                            client<<F("</tr>")<<_endl;
                            client<<F("<tr>")<<_endl;
                            client<<F("<td>Filtration: <span id=\"Filtration\">...</span></td>")<<_endl;
                            client<<F("<td>Start: <span id=\"FiltStart\">...</span></td>")<<_endl;
                            client<<F("<td>Stop: <span id=\"FiltStop\">...</span></td>")<<_endl;
                            client<<F("</tr>")<<_endl;                        
                            client<<F("</tbody>")<<_endl;
                            client<<F("</table>")<<_endl;
                            client<<F("<br>")<<_endl;

                            //Second table, pH and ORP parameters
                            client<<F("<table class=\"blueTable\">")<<_endl;
                            client<<F("<tbody>")<<_endl;
                            client<<F("<tr>")<<_endl;
                            client<<F("<td></td>")<<_endl;
                            client<<F("<td>pH</td>")<<_endl;
                            client<<F("<td>ORP/Chl</td>")<<_endl;
                            client<<F("</tr>")<<_endl;
                            client<<F("<tr>")<<_endl;
                            client<<F("<td>Value</td>")<<_endl;
                            client<<F("<td><span id=\"pH2\">...</span></td>")<<_endl;
                            client<<F("<td><span id=\"ORP2\">...</span></td>")<<_endl;
                            client<<F("</tr>")<<_endl;
                            client<<F("<td>SetPoint</td>")<<_endl;
                            client<<F("<td><span id=\"pHSetPoint\">...</span></td>")<<_endl;
                            client<<F("<td><span id=\"ORPSetPoint\">...</span></td>")<<_endl;
                            client<<F("</tr>")<<_endl;
                            client<<F("<tr>")<<_endl;
                            client<<F("<tr>")<<_endl;
                            client<<F("<td>Pump</td>")<<_endl;
                            client<<F("<td><span id=\"pHPump\">...</span></td>")<<_endl;
                            client<<F("<td><span id=\"ORPPump\">...</span></td>")<<_endl;
                            client<<F("</tr>")<<_endl;    
                            client<<F("<tr>")<<_endl;
                            client<<F("<td>Tank level</td>")<<_endl;
                            client<<F("<td><span id=\"pHTank\">...</span></td>")<<_endl;
                            client<<F("<td><span id=\"ORPTank\">...</span></td>")<<_endl;
                            client<<F("</tr>")<<_endl;               
                            client<<F("<tr>")<<_endl;
                            client<<F("<td>PID</td>")<<_endl;
                            client<<F("<td><span id=\"pHPID\">...</span></td>")<<_endl;
                            client<<F("<td><span id=\"ORPPID\">...</span></td>")<<_endl;
                            client<<F("</tr>")<<_endl;  
                            client<<F("<tr>")<<_endl;
                            client<<F("<td>Calib. coeff0</td>")<<_endl;
                            client<<F("<td><span id=\"pHCal0\">...</span></td>")<<_endl;
                            client<<F("<td><span id=\"ORPCal0\">...</span></td>")<<_endl;
                            client<<F("</tr>")<<_endl;                         
                            client<<F("<tr>")<<_endl;
                            client<<F("<td>Calib. coeff1</td>")<<_endl;
                            client<<F("<td><span id=\"pHCal1\">...</span></td>")<<_endl;
                            client<<F("<td><span id=\"ORPCal1\">...</span></td>")<<_endl;
                            client<<F("</tr>")<<_endl;
                            client<<F("<tr>")<<_endl;
                            client<<F("<td>Kp</td>")<<_endl;
                            client<<F("<td><span id=\"pHKp\">...</span></td>")<<_endl;
                            client<<F("<td><span id=\"ORPKp\">...</span></td>")<<_endl;
                            client<<F("</tr>")<<_endl;                       
                            client<<F("<tr>")<<_endl;
                            client<<F("<td>Ki</td>")<<_endl;
                            client<<F("<td><span id=\"pHKi\">...</span></td>")<<_endl;
                            client<<F("<td><span id=\"ORPKi\">...</span></td>")<<_endl;
                            client<<F("</tr>")<<_endl;                          
                            client<<F("<tr>")<<_endl;
                            client<<F("<td>Kd</td>")<<_endl;
                            client<<F("<td><span id=\"pHKd\">...</span></td>")<<_endl;
                            client<<F("<td><span id=\"ORPKd\">...</span></td>")<<_endl;
                            client<<F("</tr>")<<_endl; 
                            client<<F("<tr>")<<_endl;
                            client<<F("<td>Pumps Uptime (sec):</td>")<<_endl;
                            client<<F("<td><span id=\"pHPT\">...</span></td>")<<_endl;
                            client<<F("<td><span id=\"ChlPT\">...</span></td>")<<_endl;
                            client<<F("</tr>")<<_endl;                               
                            client<<F("</tbody>")<<_endl;
                            client<<F("</table>")<<_endl;
                            client<<F("<br>")<<_endl;

                            //Third table: Messages
                            client<<F("<table class=\"blueTable\">")<<_endl;
                            client<<F("<tbody>")<<_endl;
                            client<<F("<tr>")<<_endl;
                            client<<F("<td>Errors: <span id=\"Errors\">...</span></td>")<<_endl;
                            client<<F("<td>Acid Pump: <span id=\"PhPumpEr\">...</span></td>")<<_endl;
                            client<<F("<td>Chl Pump: <span id=\"ChlPumpEr\">...</span></td>")<<_endl;
                            client<<F("</tr>")<<_endl;
                            client<<F("</tbody>")<<_endl;
                            client<<F("</table>")<<_endl;
                            client<<F("<br>")<<_endl;
       
                            client<<F("</body>")<<_endl;
                        client<<F("</html>")<<_endl;              
                    }
                    // display received HTTP request on serial port
                    Serial<<readString<<_endl;
                        
                    // reset buffer index and all buffer elements to 0
                    readString=F("");
                    break;                
                }
                 
                // every line of text received from the client ends with \r\n
                if (c == '\n') 
                {
                    // last character on line of received text
                    // starting new line with next character read
                    currentLineIsBlank = true;
                } 
                else if (c != '\r') 
                {
                    // a text character was received from client
                    currentLineIsBlank = false;
                }
            } // end if (client.available())
        } // end while (client.connected())
        delay(1);      // give the web browser time to receive the data
        client.stop(); // close the connection
    } // end if (client)  
}


//Return an XML file with system data
//call http://localIP/Info to obtain an XML file containing the system info
void XML_response(EthernetClient cl)
{
    cl<<F("<?xml version = \"1.0\" encoding=\"UTF-8\"?>");
    cl<<F("<root>");
    
        cl<<F("<device>");
            cl<<F("<Date>");//day, weekday, month, year, hour, minute, sec
                cl<<TimeBuffer;
            cl<<F("</Date>");
            cl<<F("<Firmware>");
                cl<<Firmw;
            cl<<F("</Firmware>");
            cl<<F("<FreeRam>");
                cl<<freeRam();
            cl<<F("</FreeRam>");
            cl<<F("<IP>");
                cl<<Ethernet.localIP();
            cl<<F("</IP>");
            cl<<F("<Mac>");
                cl<<sArduinoMac;
            cl<<F("</Mac>");
            cl<<sDS18b20_0;
                cl<<TempValue;
            cl<<F("</DS18b20_0>");
            cl<<F("<PhPumpEr>");
                cl<<PhUpTimeError;
            cl<<F("</PhPumpEr>");
            cl<<F("<ChlPumpEr>");
                cl<<ChlUpTimeError;
            cl<<F("</ChlPumpEr>");
        cl<<F("</device>");

        cl<<F("<Filtration>");
            cl<<F("<Pump>");
                cl<<digitalRead(FILTRATION_PUMP);
            cl<<F("</Pump>"); 
            cl<<F("<Duration>");
                cl<<FiltrationDuration;
            cl<<F("</Duration>"); 
            cl<<F("<Start>");
                cl<<FiltrationStart;
            cl<<F("</Start>"); 
            cl<<F("<Stop>");
                cl<<FiltrationStop;
            cl<<F("</Stop>");
            cl<<F("<StopMax>");
                cl<<FiltrationStopMax;
            cl<<F("</StopMax>");
        cl<<F("</Filtration>");
                    
        cl<<F("<pH>");
            cl<<F("<Value>");
                cl<<PhValue;
            cl<<F("</Value>");           
            cl<<F("<Pump>");
                cl<<digitalRead(PH_PUMP);
            cl<<F("</Pump>");
            cl<<F("<UpT>");
                cl<<PhPumpTimeCounter;
            cl<<F("</UpT>");
            cl<<F("<TankLevel>");
                cl<<digitalRead(PH_LEVEL);
            cl<<F("</TankLevel>");
            cl<<F("<PIDMode>");
                cl<<Ph_RegulationOnOff;
            cl<<F("</PIDMode>");
            cl<<F("<Kp>");
                cl<<Ph_Kp;
            cl<<F("</Kp>");
            cl<<F("<Ki>");
                cl<<Ph_Ki;
            cl<<F("</Ki>");
            cl<<F("<Kd>");
                cl<<Ph_Kd;
            cl<<F("</Kd>");
            cl<<F("<SetPoint>");
                cl<<Ph_SetPoint;
            cl<<F("</SetPoint>");
            cl<<F("<CalibCoeff0>");
                cl<<pHCalibCoeffs[0];
            cl<<F("</CalibCoeff0>");
            cl<<F("<CalibCoeff1>");
                cl<<pHCalibCoeffs[1];
            cl<<F("</CalibCoeff1>");       
        cl<<F("</pH>");

        cl<<F("<ORP>");
            cl<<F("<Value>");
                cl<<OrpValue;
            cl<<F("</Value>");           
            cl<<F("<Pump>");
                cl<<digitalRead(CHL_PUMP);
            cl<<F("</Pump>");
            cl<<F("<UpT>");
                cl<<ChlPumpTimeCounter;
            cl<<F("</UpT>");
            cl<<F("<TankLevel>");
                cl<<digitalRead(CHL_LEVEL);
            cl<<F("</TankLevel>");
            cl<<F("<PIDMode>");
                cl<<Orp_RegulationOnOff;
            cl<<F("</PIDMode>");
            cl<<F("<Kp>");
                cl<<Orp_Kp;
            cl<<F("</Kp>");
            cl<<F("<Ki>");
                cl<<Orp_Ki;
            cl<<F("</Ki>");
            cl<<F("<Kd>");
                cl<<Orp_Kd;
            cl<<F("</Kd>");
            cl<<F("<SetPoint>");
                cl<<Orp_SetPoint;
            cl<<F("</SetPoint>");
            cl<<F("<CalibCoeff0>");
                cl<<OrpCalibCoeffs[0];
            cl<<F("</CalibCoeff0>");
            cl<<F("<CalibCoeff1>");
                cl<<OrpCalibCoeffs[1];
            cl<<F("</CalibCoeff1>");
        cl<<F("</ORP>");
        
    cl<<F("</root>");
}
