Loic74650/PoolMaster/source/PoolMaster/DebugUtils.h

/*
DebugUtils.h - Simple debugging utilities.
Copyright (C) 2011 Fabio Varesano <fabio at varesano dot net>

Ideas taken from:
http://www.arduino.cc/cgi-bin/yabb2/YaBB.pl?num=1271517197

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
*/

#ifndef DEBUGUTILS_H
#define DEBUGUTILS_H

#ifdef DEBUG
#include <Arduino.h>
#define DEBUG_PRINT2(str)    \
   Serial.print(millis());     \
   Serial.print(": ");    \
   Serial.print(__PRETTY_FUNCTION__); \
   Serial.print(' ');      \
   Serial.print(__FILE__);     \
   Serial.print(':');      \
   Serial.print(__LINE__);     \
   Serial.print(' ');      \
   Serial.println(str);

#define DEBUG_PRINT(str)    \
   Serial.print(millis());     \
   Serial.print(": ");    \
   Serial.print(__PRETTY_FUNCTION__); \
   Serial.print(':');      \
   Serial.print(' ');      \
   Serial.println(str);   
#else
#define DEBUG_PRINT(str)
#define DEBUG_PRINT2(str)
#endif

#endif
