Loic74650/PoolMaster/(commit log)

2019-03-08 improvements and bug fixes
    changed Eeprom config storage handling
    added incoming MQTT message queue to reduce load on MQTT callback function (causing spurious socket errors and subsequent disconnections from broker)
    Ethernet deconnection now non-blocking
    Some minor changes
    [PoolMaster.ino]
2019-03-19 Code now compiles on Mega2560 boards
2019-03-25 NodeRed to BLynk code and flow docs
2019-05-10 I2C LCD
2019-07-14 Front panel push-button support
2019-09-10 Update PoolMaster.ino
    Added water temperature regulation loop
2020-01-04 Updated NodeRed complete flow
2020-01-15 added wiring diagram
2020-02-05 modified Pump class to handle case where filtration pump is not managed by the Arduino
2020-02-18 fixed bug preventing manual operation of pumps
    [PoolMaster.ino]
2020-03-28 added NodeRed Grafana flow
2020-04-23 fix RTC settim with arduino mega_2560
    [PoolMaster.ino]
2020-05-25 Update PoolMaster.ino
    FIx sync Time with RTC and use setSyncProvider instead of setTime
    [PoolMaster.ino]
2020-05-25 Node-Red-Dashboard to control Poolmaster
    To avoid having to use a MQTT publisher
    Installation:
    1) Manage palette in node-red and add node-red-dashboard
    2) Import json
    3) Enjoy the dashboard V1.3 by surfing to your node-red server/ui
    Future version should reflect real-time config (this version remembers your last config made through this dashboard, and does not reflect changes made by the Arduino or by you using MQQTfx or BLYNK)
2020-05-30 smart-button new features, thanks to bbwouters
2020-05-31 v4.0.5
    * Removed PIDs handling from FiltPump function
    * reseting EmergencyStopFiltPump variable at midnight
    * added state values of relays R1, R2, R6 and R7 to Bitmap2
    [Config.h, PoolMaster.ino]
2020-05-31 v4.0.6
    Added profiling utility to measure duration of PublishCallback. It currently takes 60ms to publish the two MQTT payloads
2020-06-03 add frame rate settings via mqtt
2020-06-04 Fix wording frame to / flow...
    [PoolMaster.ino]
2020-06-09 small fixes
    Basic functionality of Nextion TFT
    working.
    Probes calibrations and settings tabs still missing
    [Config.h, Nextion.ino, PoolMaster.ino]
2020-06-14 TFT now supporting errors clearing and probes calibration
    [Config.h, Nextion.ino]
2020-06-16 fixed bug with DelayPID
    [Config.h, PoolMaster.ino]
2020-07-14 Pump UPTime bug fix
    [Config.h, Nextion.ino, PoolMaster.ino]
2020-11-18 Create mounting info.pdf
2023-04-15 Added Pump files into project to avoid compilation struggles
    [PoolMaster.ino, Pump.cpp, Pump.h]
2023-04-22 corrected wrong EasyNex library version in comments
    [PoolMaster.ino]
2023-07-25 Update PoolMaster.HMI
    Moved time display from Arduino to Nextion RTC
2023-08-14 update wiring diagram (pH_Orp_Board PSU)
2025-05-04 Fixed incorrect error condition in ProcessCommand that made it impossible to send MQTT API commands
    [PoolMaster.ino]
2025-05-09 Updated pH_Orp board I2C address
2025-08-21 trying to fix MQTT deconnection issues
    [Config.h, PoolMaster.ino]
